Gigabyte1973/Gigabyte1973/README.md

# Gigabyte1973
BMS with RS485 comunication
