Gigabyte1973/Gigabyte1973/RS485 Slave BMS V3.3.brd

## EAGLE design RS485 Slave BMS V3.3.brd (2019-11-26)

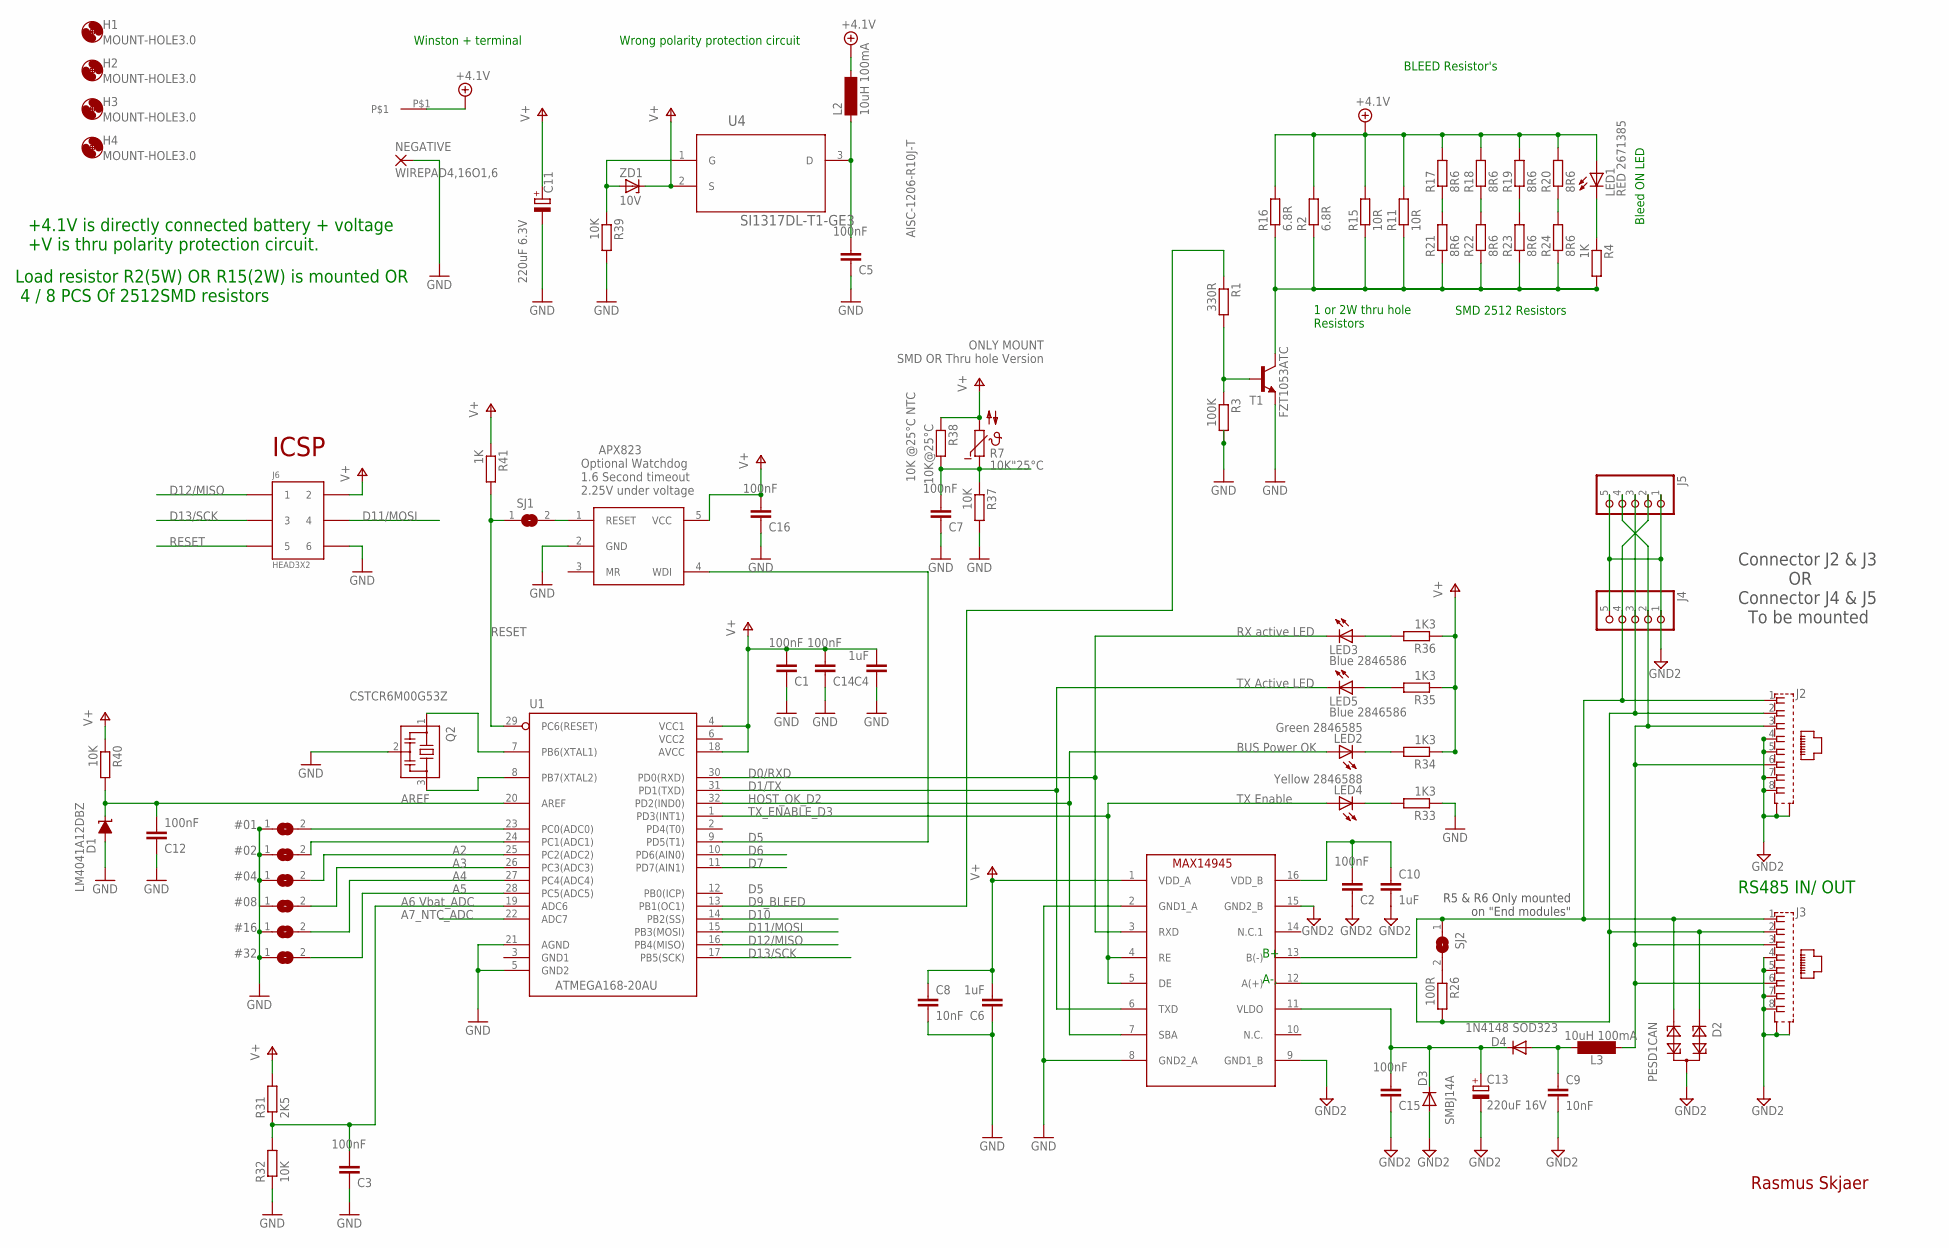
[picture p1: schematic RS485 Slave BMS V3.3.sch]

Parts:
#01, #02, #04, #08, #16, #32: SJ
C1, C2, C3, C5, C7, C12, C14, C15, C16: 100nF; C0603
C4, C6: 1uF; C0805
C8, C9: 10nF; C0603
C10: 1uF; C1206
C11: 220uF 6.3V; CT6032
C13: 220uF 16V; D/7343-31R
D1: LM4041A12DBZ; DBZ_R-PDSO-G3
D2: PESD1CAN; SOT23
D3: SMBJ14A; DO214AC
D4: 1N4148 SOD323; SOD323-R
H1, H2, H3, H4: MOUNT-HOLE3.0; 3,0
IC2: MAX14945; SOW16
J2, J3: 555153-1
J4, J5: PINHD-1X5/90; 1X05/90
J6: HEAD3X2
L2, L3: 10uH 100mA; SM-1206
LED1: RED 2671385; CHIP-LED0805
LED2: Green 2846585; CHIP-LED0805
LED3, LED5: Blue 2846586; CHIP-LED0805
LED4: Yellow 2846588; CHIP-LED0805
NEGATIVE: WIREPAD4,16O1,6; 4,16O1,6
Q2: CSTCR6M00G53Z; CSTCR6M
R1: 330R; R0603
R2, R16: 6.8R; V235/17
R3: 100K; R0603
R4, R41: 1K; R0603
R7: 10K"25°C; B57164
R11, R15: 10R; V234/12
R17, R18, R19, R20, R21, R22, R23, R24: 8R6; R2512
R26: 100R; R0805
R31: 2K5; R0603
R32, R37, R39, R40: 10K; R0603
R33, R34, R35, R36: 1K3; R0603
R38: 10K@25°C; R0603
SJ1, SJ2: SJ
T1: FZT1053ATC; SOT223
U1: ATMEGA168-20AU; QFP032
U2: APX823SOT25*; SOT23-5L
U4: SI1317DL-T1-GE3; SOT65P210X110-3N
U$1: WINSTON-160AH-TERMINAL
ZD1: 10V; SOD123

Connections:
+4.1V: L2.2, LED1.A, R2.2, R11.2, R15.2, R16.2, R17.2, R18.2, R19.2, R20.2, U$1.P$1
A2: #04.2, U1.25 (PC2(ADC2))
A3: #08.2, U1.26 (PC3(ADC3))
A4: #16.2, U1.27 (PC4(ADC4))
A5: #32.2, U1.28 (PC5(ADC5))
A6: C3.1, R31.1, R32.2, U1.19 (ADC6)
A7_NTC_ADC: C7.1, R7.1, R37.1, R38.2, U1.22 (ADC7)
A-: D2.1, IC2.12 (A(+)), J2.2, J3.2, J4.3, J5.3, R26.2
AREF: C12.1, D1.1 (C), R40.2, U1.20 (AREF)
B+: D2.2, IC2.13 (B(-)), J2.1, J3.1, J4.4, J5.2, SJ2.1
BLEED: R2.1, R4.2, R11.1, R15.1, R16.1, R21.1, R22.1, R23.1, R24.1, T1.4 (C)
D0/RXD: IC2.3 (RXD), LED3.C, U1.30 (PD0(RXD))
D1/TX: IC2.6 (TXD), LED5.C, U1.31 (PD1(TXD))
D5: U1.9 (PD5(T1)), U2.4 (WDI)
D6: U1.10 (PD6(AIN0))
D7: U1.11 (PD7(AIN1))
D9_BLEED: R1.1, U1.13 (PB1(OC1))
D10: U1.14 (PB2(SS))
D11/MOSI: J6.4, U1.15 (PB3(MOSI))
D12/MISO: J6.1, U1.16 (PB4(MISO))
D13/SCK: J6.3, U1.17 (PB5(SCK))
DCIN: J2.3, J2.6, J3.3, J3.6, J4.2, J5.4, L3.2
GND: #01.1, #02.1, #04.1, #08.1, #16.1, #32.1, C1.2, C3.2, C4.1, C5.2, C6.1, C7.2, C8.2, C11.-, C12.2, C14.2, C16.2, D1.2 (A), IC2.2 (GND1_A), IC2.8 (GND2_A), J6.6, NEGATIVE.1, Q2.2, R3.2, R32.1, R33.1, R37.2, R39.2, T1.3 (E), U1.5 (GND2), U1.21 (AGND), U2.2 (GND)
GND1: U1.3 (GND1)
GND2: C2.2, C9.2, C10.2, C13.-, C15.2, D2.3, D3.A, IC2.9 (GND1_B), IC2.15 (GND2_B), J2.4, J2.5, J2.7, J2.8, J2.G1 (S1), J2.G2 (S2), J3.4, J3.5, J3.7, J3.8, J3.G1 (S1), J3.G2 (S2), J4.1, J4.5, J5.1, J5.5
HOST_OK_D2: IC2.7 (SBA), LED2.A, U1.32 (PD2(IND0))
unnamed: R1.2, R3.1, T1.1 (B)
unnamed: #02.2, U1.24 (PC1(ADC1))
unnamed: LED4.C, R33.2
unnamed: LED3.A, R36.2
unnamed: R39.1, U4.1 (G), ZD1.A
unnamed: LED5.A, R35.2
unnamed: C5.1, L2.1, U4.3 (D)
unnamed: #01.2, U1.23 (PC0(ADC0))
unnamed: LED2.C, R34.2
unnamed: LED1.C, R4.1
unnamed: SJ1.2, U2.1 (RESET)
unnamed: C9.1, D4.A, L3.1
unnamed: R26.1, SJ2.2
unnamed: R20.1, R24.2
unnamed: R19.1, R23.2
unnamed: R18.1, R22.2
unnamed: R17.1, R21.2
unnamed: Q2.1, U1.7 (PB6(XTAL1))
unnamed: Q2.3, U1.8 (PB7(XTAL2))
RESET: J6.5, R41.2, SJ1.1, U1.29 (PC6(RESET))
TX_ENABLE_D3: IC2.4 (RE), IC2.5 (DE), LED4.A, U1.1 (PD3(INT1))
V+: C1.1, C4.2, C6.2, C8.1, C11.+, C14.1, C16.1, IC2.1 (VDD_A), J6.2, R7.2, R31.2, R34.1, R35.1, R36.1, R38.1, R40.1, R41.1, U1.4 (VCC1), U1.18 (AVCC), U2.5 (VCC), U4.2 (S), ZD1.C
VCC2: U1.6 (VCC2)
VCC2_FILTER: C13.+, C15.1, D3.C, D4.C, IC2.11 (VLDO)
VDD_B: C2.1, C10.1, IC2.16 (VDD_B)

Notes on the sheet:
BLEED Resistor's
Bleed ON LED
Wrong polarity protection circuit
+4.1V is directly connected battery + voltage +V is thru polarity protection circuit.
Load resistor R2(5W) OR R15(2W) is mounted OR 4 / 8 PCS Of 2512SMD resistors
Winston + terminal
SMD 2512 Resistors
1 or 2W thru hole Resistors
RX active LED
TX Enable
TX Active LED
10K @25°C NTC
Rasmus Skjaer
RS485 IN/ OUT
R5 & R6 Only mounted on "End modules"
Connector J2 & J3 OR Connector J4 & J5 To be mounted
AISC-1206-R10J-T
ONLY MOUNT SMD OR Thru hole Version
A-,
ICSP
APX823 Optional Watchdog 1.6 Second timeout 2.25V under voltage
BUS Power OK
A6 Vbat_ADC

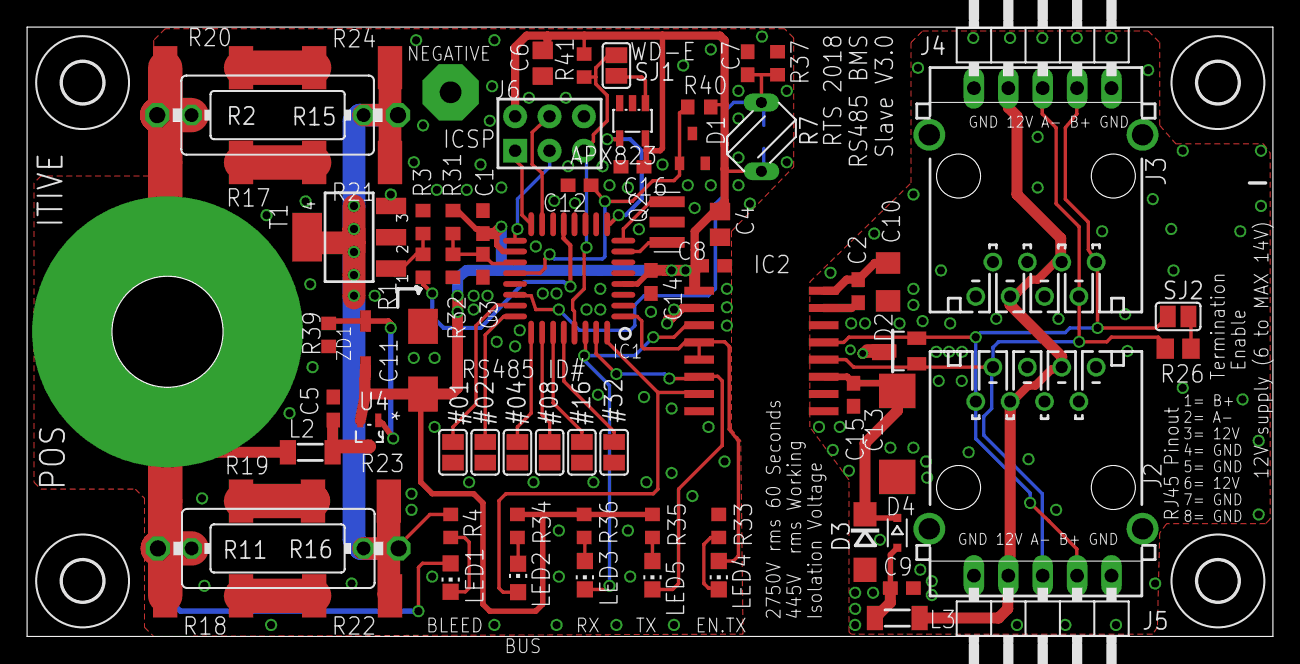
[picture p2: board RS485 Slave BMS V3.3.brd from above]

Board: 2 copper layers, 92.0 x 45.0 mm, 82 parts (1 on the bottom side), 46 nets.

Other parts of the board:
U$2: A4L-LOC
