Gigabyte1973/Gigabyte1973/Rs485 current sense V1.1.brd

## EAGLE design Rs485 current sense V1.1.brd (2019-11-26)

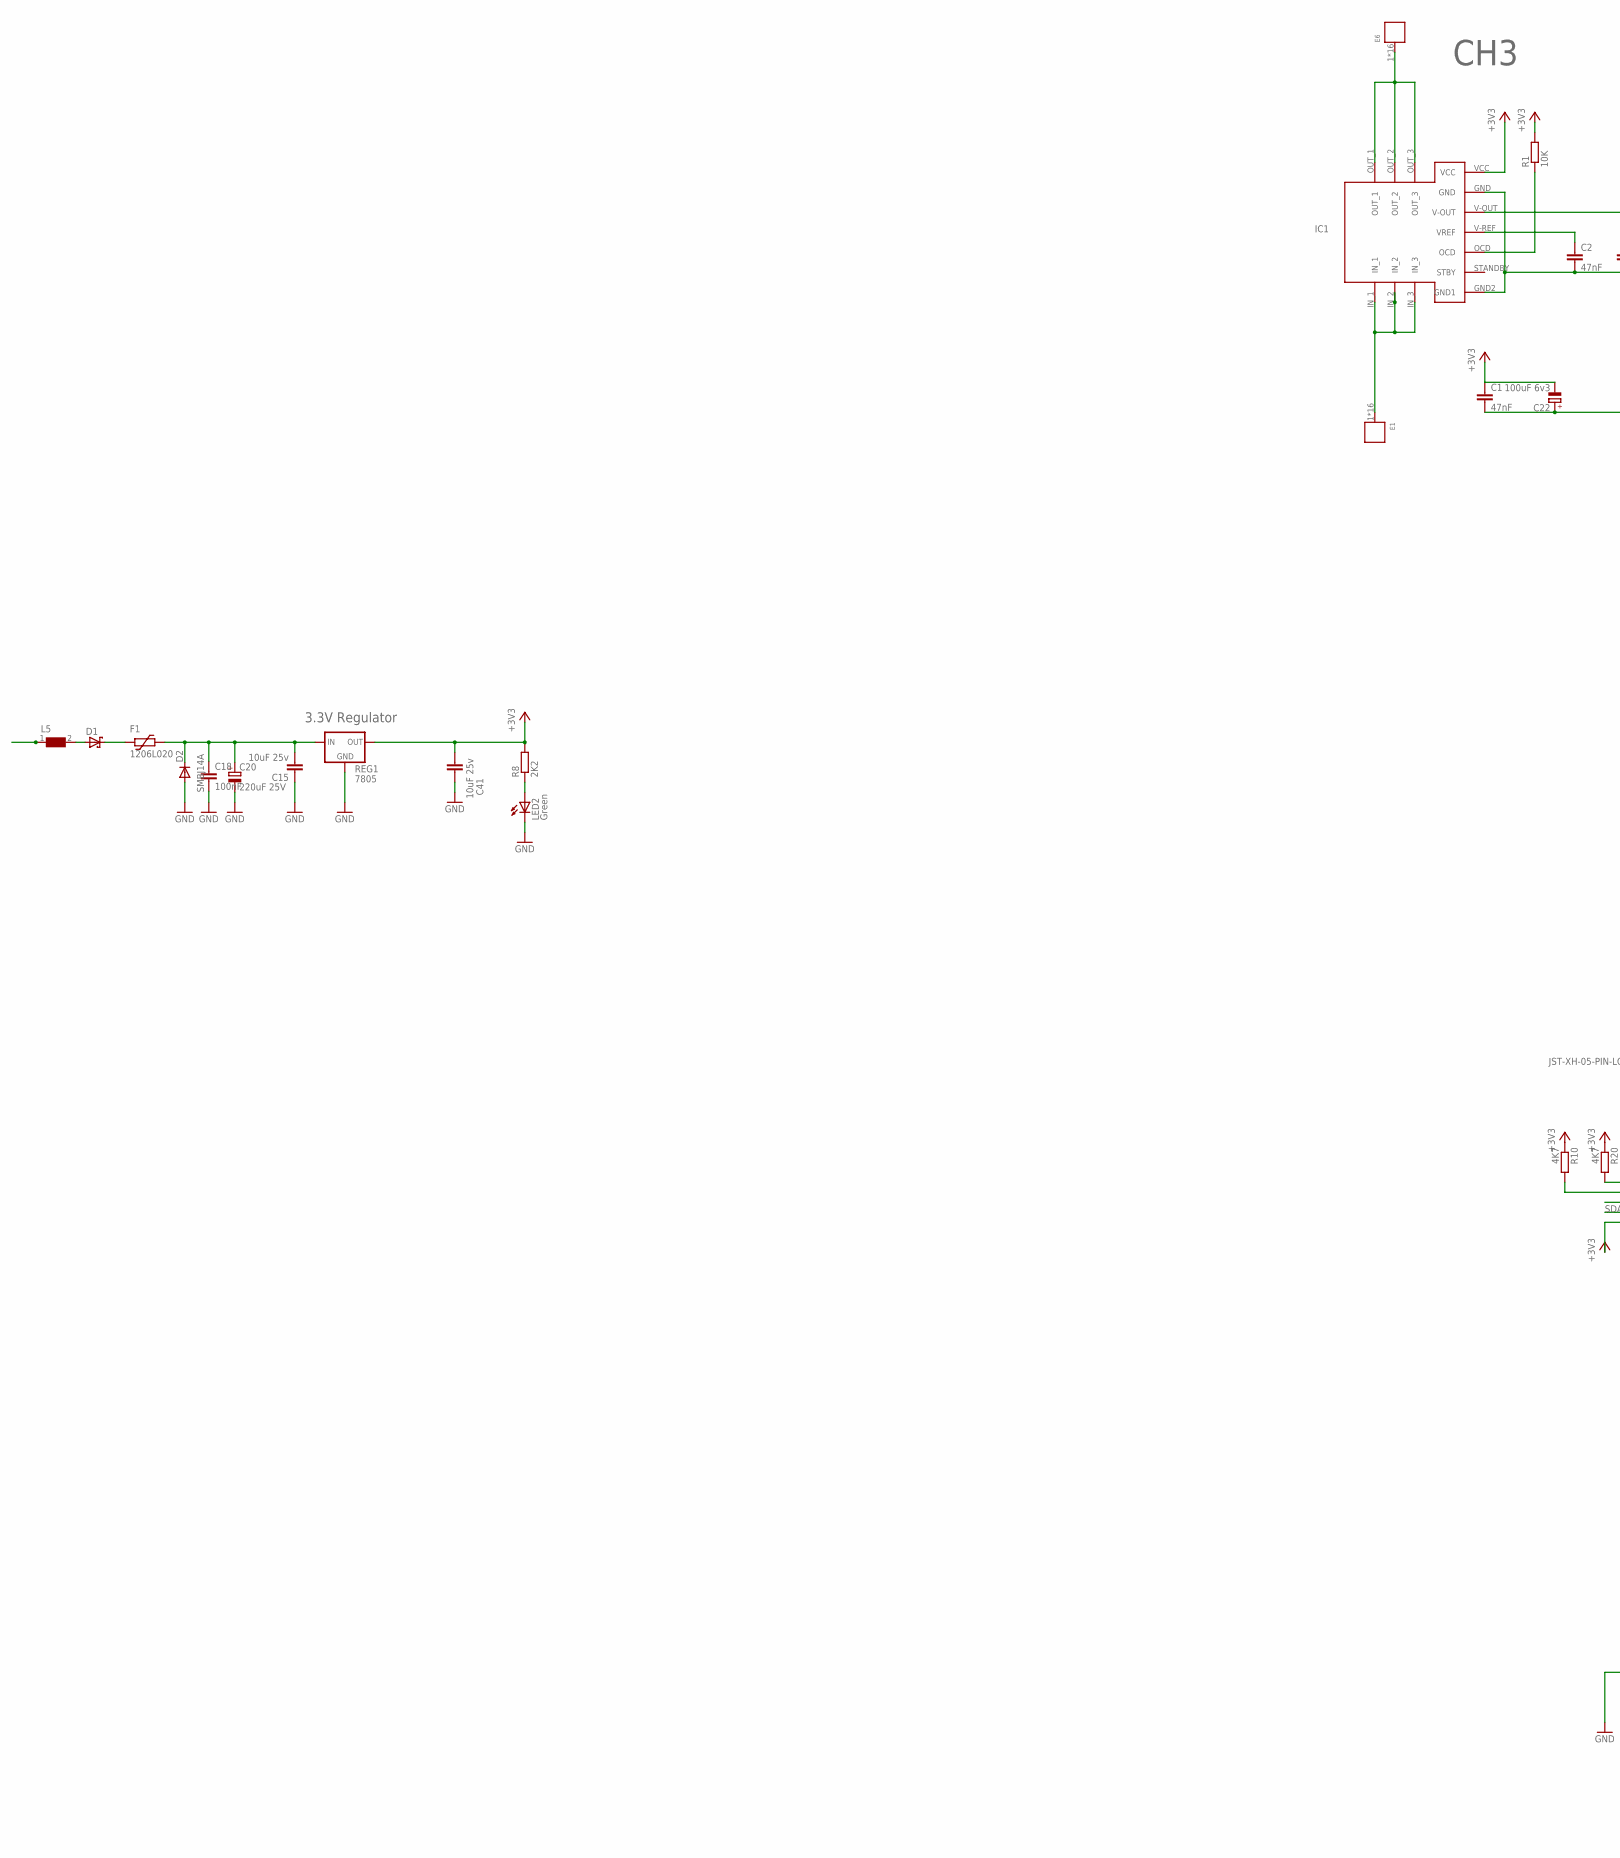
[picture p3: schematic Rs485 current sense V1.1.sch, part in row 1, column 1]

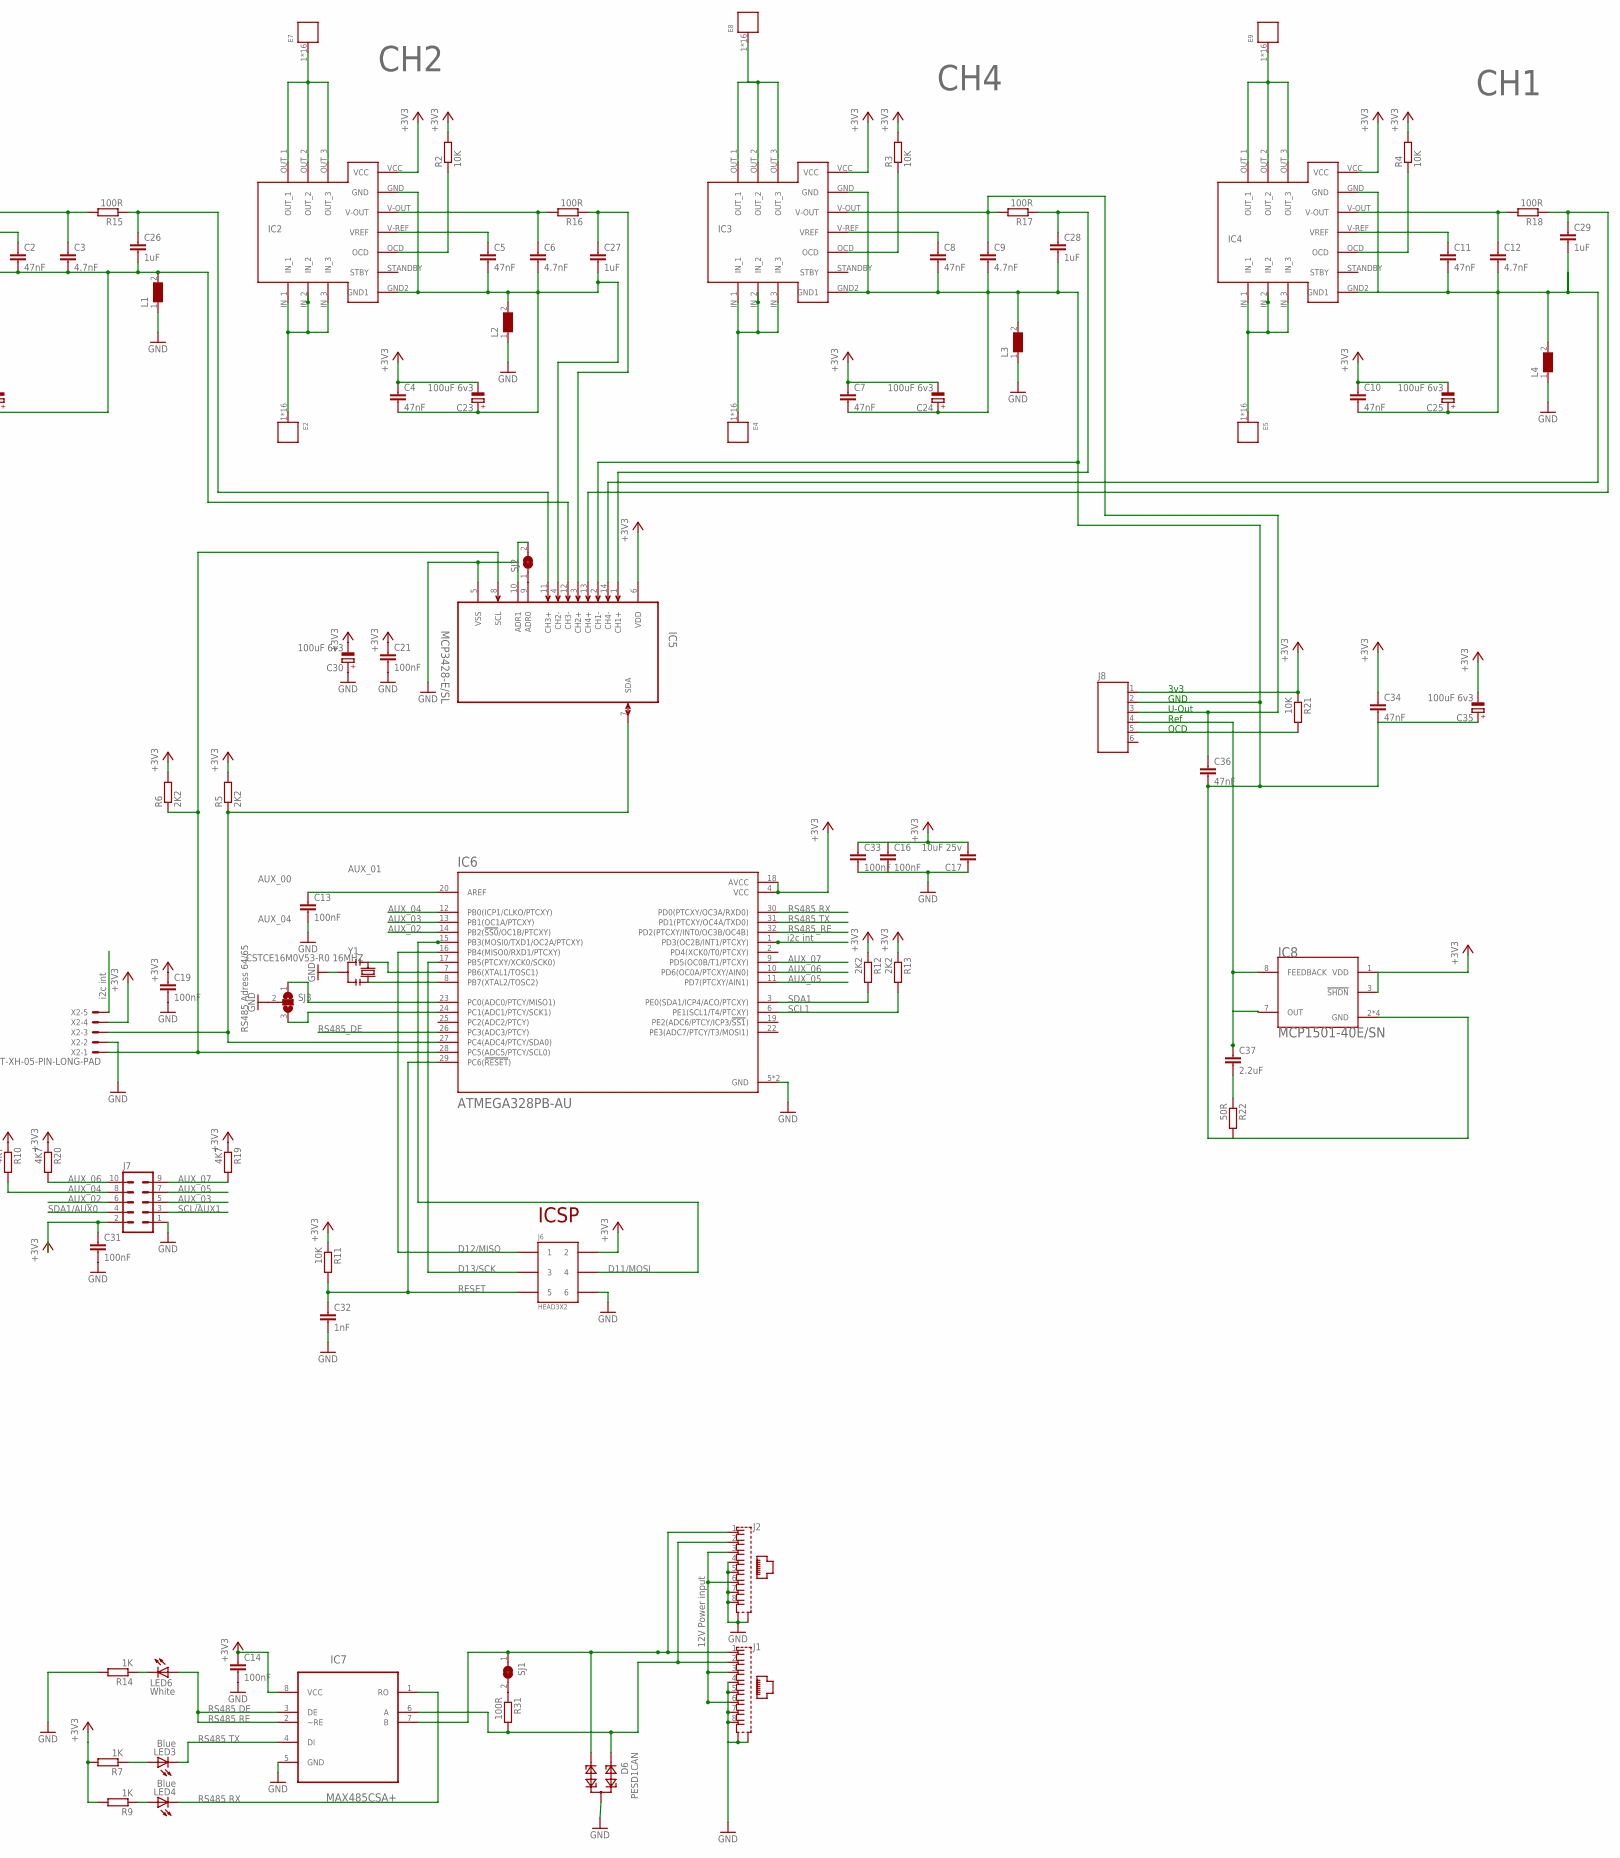
[picture p4: schematic Rs485 current sense V1.1.sch, part in row 1, column 2]

Parts:
C1, C2, C4, C5, C7, C8, C10, C11, C34, C36: 47nF; C0603
C3, C6, C9, C12: 4.7nF; C0603
C13, C14, C16, C18, C19, C21, C31, C33: 100nF; C0603
C15, C17, C41: 10uF 25v; C1206
C20: 220uF 25V; PANASONIC_F
C22, C23, C24, C25, C30, C35: 100uF 6v3; CT3528
C26, C27, C28, C29: 1uF; C0603
C32: 1nF; C0603
C37: 2.2uF; C0805
D1: SCHOTTKY-DIODESMD; SMB
D2: SMBJ14A; DO214AC
D6: PESD1CAN; SOT23
E1, E2, E4, E5, E6, E7, E8, E9: WP-BUFU_J(10); 16PINS_10X10_FULL
F1: 1206L020; 1206L
IC1, IC2, IC3, IC4: HO15-NP/SP33-1000
IC5: MCP3428-E/SL; SOIC127P600X175-14N
IC6: ATMEGA328PB-AU; QFP80P900X900X120-32N
IC7: MAX485CSA+; SOIC127P600X175-8N
IC8: MCP1501-40E/SN; SOIC127P600X175-8N
J1, J2: 555153-1
J6: HEAD3X2
J7: MA05-2
J8: JST-PH6
L1, L2, L3, L4: WE-CBF-74279209_0805; 0805
L5: WE-CBF-7427922_1206; 1206
LED2: Green; CHIPLED_0805
LED3, LED4: Blue; CHIPLED_0805
LED6: White; CHIPLED_0805
R1, R2, R3, R4, R11, R21: 10K; R0603
R5, R6, R12, R13: 2K2; R0603
R7, R9, R14: 1K; R0805
R8: 2K2; R0805
R10, R19, R20: 4K7; R0603
R15, R16, R17, R18: 100R; R0603
R22: 50R; R0603
R31: 100R; R0805
REG1: 7805; 78XXS
SJ1, SJ2: SJ
SJ3: SJ2W; SJ_2
X2: JST-XH-05-PIN-LONG-PAD; JST-XH-05-PACKAGE-LONG-PAD
Y1: CSTCE16M0V53-R0 16MHZ; RESONATOR

Connections:
1GNDA: C10.2, C11.2, C12.2, C25.- (+), C29.2, IC4.GND, IC4.GND2 (GND1), IC5.14 (CH4-), L4.2
1_IN: E5.1, E5.2, E5.3, E5.4, E5.5, E5.6, E5.7, E5.8, E5.9, E5.10, E5.11, E5.12, E5.13, E5.14, E5.15, E5.16, IC4.IN_1, IC4.IN_2, IC4.IN_3
1_OUT: E9.1, E9.2, E9.3, E9.4, E9.5, E9.6, E9.7, E9.8, E9.9, E9.10, E9.11, E9.12, E9.13, E9.14, E9.15, E9.16, IC4.OUT_1, IC4.OUT_2, IC4.OUT_3
2GND: C4.2, C5.2, C6.2, C23.- (+), C27.2, IC2.GND, IC2.GND2 (GND1), IC5.4 (CH2-), L2.2
2_IN: E2.1, E2.2, E2.3, E2.4, E2.5, E2.6, E2.7, E2.8, E2.9, E2.10, E2.11, E2.12, E2.13, E2.14, E2.15, E2.16, IC2.IN_1, IC2.IN_2, IC2.IN_3
2_OUT: E7.1, E7.2, E7.3, E7.4, E7.5, E7.6, E7.7, E7.8, E7.9, E7.10, E7.11, E7.12, E7.13, E7.14, E7.15, E7.16, IC2.OUT_1, IC2.OUT_2, IC2.OUT_3
3GND: C1.2, C2.2, C3.2, C22.- (+), C26.2, IC1.GND, IC1.GND2 (GND1), IC5.12 (CH3-), L1.2
3_IN: E1.1, E1.2, E1.3, E1.4, E1.5, E1.6, E1.7, E1.8, E1.9, E1.10, E1.11, E1.12, E1.13, E1.14, E1.15, E1.16, IC1.IN_1, IC1.IN_2, IC1.IN_3
3_OUT: E6.1, E6.2, E6.3, E6.4, E6.5, E6.6, E6.7, E6.8, E6.9, E6.10, E6.11, E6.12, E6.13, E6.14, E6.15, E6.16, IC1.OUT_1, IC1.OUT_2, IC1.OUT_3
4GNDA: C7.2, C8.2, C9.2, C24.- (+), C28.2, C34.2, C35.- (+), C36.2, IC3.GND, IC3.GND2 (GND1), IC5.2 (CH1-), IC8.2 (GND), IC8.4 (GND), IC8.5 (GND), IC8.6 (GND), J8.2, L3.2, R22.2
4_IN: E4.1, E4.2, E4.3, E4.4, E4.5, E4.6, E4.7, E4.8, E4.9, E4.10, E4.11, E4.12, E4.13, E4.14, E4.15, E4.16, IC3.IN_1, IC3.IN_2, IC3.IN_3
4_OUT: E8.1, E8.2, E8.3, E8.4, E8.5, E8.6, E8.7, E8.8, E8.9, E8.10, E8.11, E8.12, E8.13, E8.14, E8.15, E8.16, IC3.OUT_1, IC3.OUT_2, IC3.OUT_3
12V: J1.3, J1.6, J2.3, J2.6, L5.1
+3V3: C1.1, C4.1, C7.1, C10.1, C14.1, C16.1, C17.2, C19.1, C21.1, C22.+ (-), C23.+ (-), C24.+ (-), C25.+ (-), C30.+ (-), C31.1, C33.1, C34.1, C35.+ (-), C41.2, IC1.VCC, IC2.VCC, IC3.VCC, IC4.VCC, IC5.6 (VDD), IC6.4 (VCC), IC6.18 (AVCC), IC7.8 (VCC), IC8.1 (VDD), IC8.3 (!SHDN), J6.2, J7.2, J8.1, R1.2, R2.2, R3.2, R4.2, R5.2, R6.2, R7.2, R8.2, R9.2, R10.1, R11.1, R12.1, R13.1, R19.1, R20.1, R21.1, REG1.OUT, X2.4
ATMEGA-AREF: C13.1, IC6.20 (AREF)
AUX_02: IC6.14 (PB2(!SS0!/OC1B/PTCXY)), J7.6
AUX_03: IC6.13 (PB1(OC1A/PTCXY)), J7.5
AUX_04: IC6.12 (PB0(ICP1/CLKO/PTCXY)), J7.8, R10.2
AUX_05: IC6.11 (PD7(PTCXY/AIN1)), J7.7
AUX_06: IC6.10 (PD6(OC0A/PTCXY/AIN0)), J7.10, R20.2
AUX_07: IC6.9 (PD5(OC0B/T1/PTCXY)), J7.9, R19.2
CH1-OUTA: C29.1, IC5.13 (CH4+), R18.1
CH2-OUT: C27.1, IC5.3 (CH2+), R16.1
CH3-OUT: C26.1, IC5.11 (CH3+), R15.1
CH4-OUTA: C28.1, IC5.1 (CH1+), R17.1
D11/MOSI: IC6.15 (PB3(MOSI0/TXD1/OC2A/PTCXY)), J6.4
D12/MISO: IC6.16 (PB4(MISO0/RXD1/PTCXY)), J6.1
D13/SCK: IC6.17 (PB5(PTCXY/XCK0/SCK0)), J6.3
GND: C13.2, C14.2, C15.1, C16.2, C17.1, C18.2, C19.2, C20.-, C21.2, C30.- (+), C31.2, C32.2, C33.2, C41.1, D2.A, D6.3, IC5.5 (VSS), IC5.10 (ADR1), IC6.5 (GND), IC6.21 (GND), IC7.5 (GND), J1.4, J1.5, J1.7, J1.8, J1.G1 (S1), J1.G2 (S2), J2.4, J2.5, J2.7, J2.8, J2.G1 (S1), J2.G2 (S2), J6.6, J7.1, L1.1, L2.1, L3.1, L4.1, LED2.C, R14.2, REG1.GND, SJ2.2, SJ3.2, X2.2, Y1.2
I2C_INT: IC6.1 (PD3(OC2B/INT1/PTCXY)), X2.5
I2C_SCL: IC5.8 (SCL), IC6.28 (PC5(ADC5/PTCY/SCL0)), R6.1, X2.1
I2C_SDA: IC5.7 (SDA), IC6.27 (PC4(ADC4/PTCY/SDA0)), R5.1, X2.3
unnamed: IC6.23 (PC0(ADC0/PTCY/MISO1)), SJ3.1
unnamed: IC1.OCD, R1.1
unnamed: IC6.24 (PC1(ADC1/PTCY/SCK1)), SJ3.3
unnamed: C2.1, IC1.V-REF (VREF)
unnamed: J8.5, R21.2
unnamed: C9.1, C36.1, IC3.V-OUT, J8.3, R17.2
unnamed: C37.1, IC8.7 (OUT), IC8.8 (FEEDBACK), J8.4
unnamed: IC2.OCD, R2.1
unnamed: C5.1, IC2.V-REF (VREF)
unnamed: C6.1, IC2.V-OUT, R16.2
unnamed: C37.2, R22.1
unnamed: D1.A, L5.2
unnamed: IC3.OCD, R3.1
unnamed: C8.1, IC3.V-REF (VREF)
unnamed: IC4.OCD, R4.1
unnamed: C11.1, IC4.V-REF (VREF)
unnamed: IC6.8 (PB7(XTAL2/TOSC2)), Y1.3
unnamed: LED2.A, R8.1
unnamed: D1.C, F1.2
unnamed: LED3.A, R7.1
unnamed: LED4.A, R9.1
unnamed: LED6.C, R14.1
unnamed: IC5.9 (ADR0), SJ2.1
unnamed: C3.1, IC1.V-OUT, R15.2
unnamed: C12.1, IC4.V-OUT, R18.2
unnamed: R31.1, SJ1.2
RESET: C32.1, IC6.29 (PC6(!RESET!)), J6.5, R11.2
RS485_DE: IC6.26 (PC3(ADC3/PTCY)), IC7.2 (~RE), IC7.3 (DE), LED6.A
RS485_N: D6.1, IC7.6 (A), J1.2, J2.2, R31.2
RS485_P: D6.2, IC7.7 (B), J1.1, J2.1, SJ1.1
RS485_RE: IC6.32 (PD2(PTCXY/INT0/OC3B/OC4B))
RS485_RX: IC6.30 (PD0(PTCXY/OC3A/RXD0)), IC7.1 (RO), LED4.C
RS485_TX: IC6.31 (PD1(PTCXY/OC4A/TXD0)), IC7.4 (DI), LED3.C
SCL1: IC6.6 (PE1(SCL1/T4/PTCXY)), J7.3, R13.2
SDA1: IC6.3 (PE0(SDA1/ICP4/ACO/PTCXY)), J7.4, R12.2
VBAT12V: C15.2, C18.1, C20.+, D2.C, F1.1, REG1.IN
XTAL2: IC6.7 (PB6(XTAL1/TOSC1)), Y1.1

Notes on the sheet:
RS485 TX
RS485 RX
RS485 RE
RS485 DE
3.3V Regulator
IC1
IC2
IC3
IC4
ICSP
RS485_RE
RS485_DE
AUX_06
AUX_07
AUX_05
AUX_03
AUX_04
AUX_02
AUX_01
AUX_00
SCL1
SDA1
SDA1/AUX0
SCL/AUX1
RS485 Adress 64/65
3v3
GND
Ref
U-Out
OCD
CH4
CH1
CH2
CH3
i2c int
12V Power input

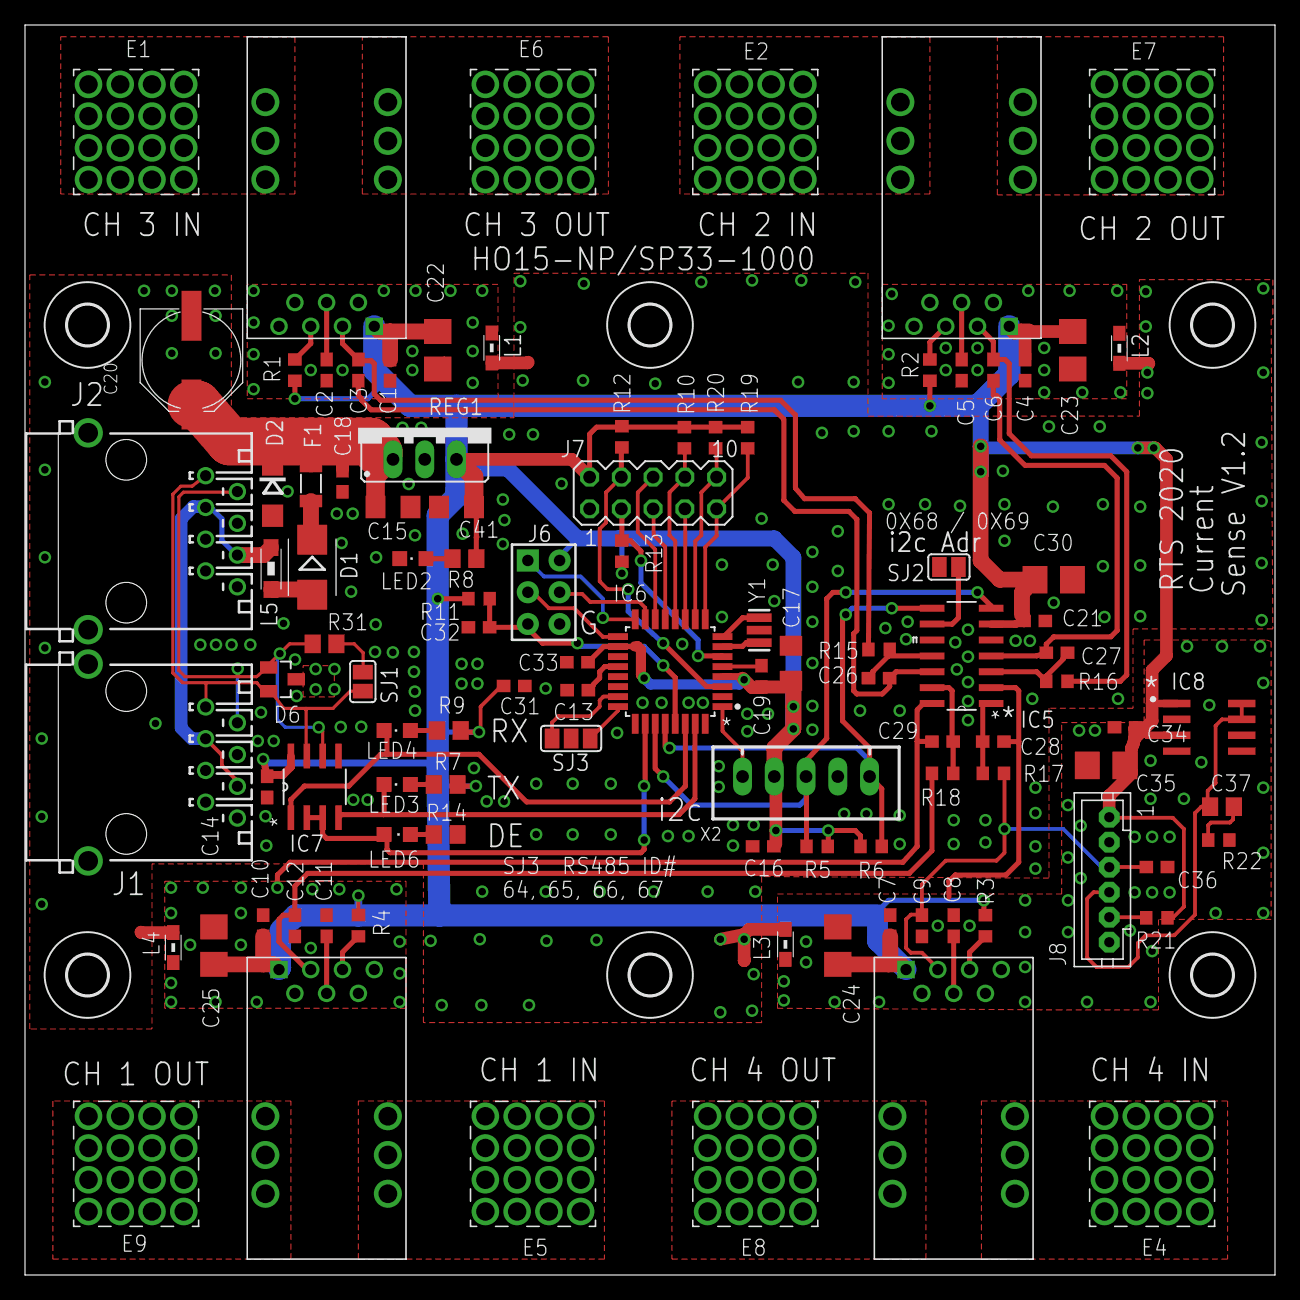
[picture p5: board Rs485 current sense V1.1.brd from above]

Board: 2 copper layers, 100.0 x 100.0 mm, 107 parts (0 on the bottom side), 68 nets.

Other parts of the board:
U$2, U$3, U$4, U$5, U$6, U$7: 3,2
