Gigabyte1973/Gigabyte1973/BMS Master Teensy V 2.22 move 4G.brd

## EAGLE design BMS Master Teensy V 2.22 move 4G.brd (2019-11-26)

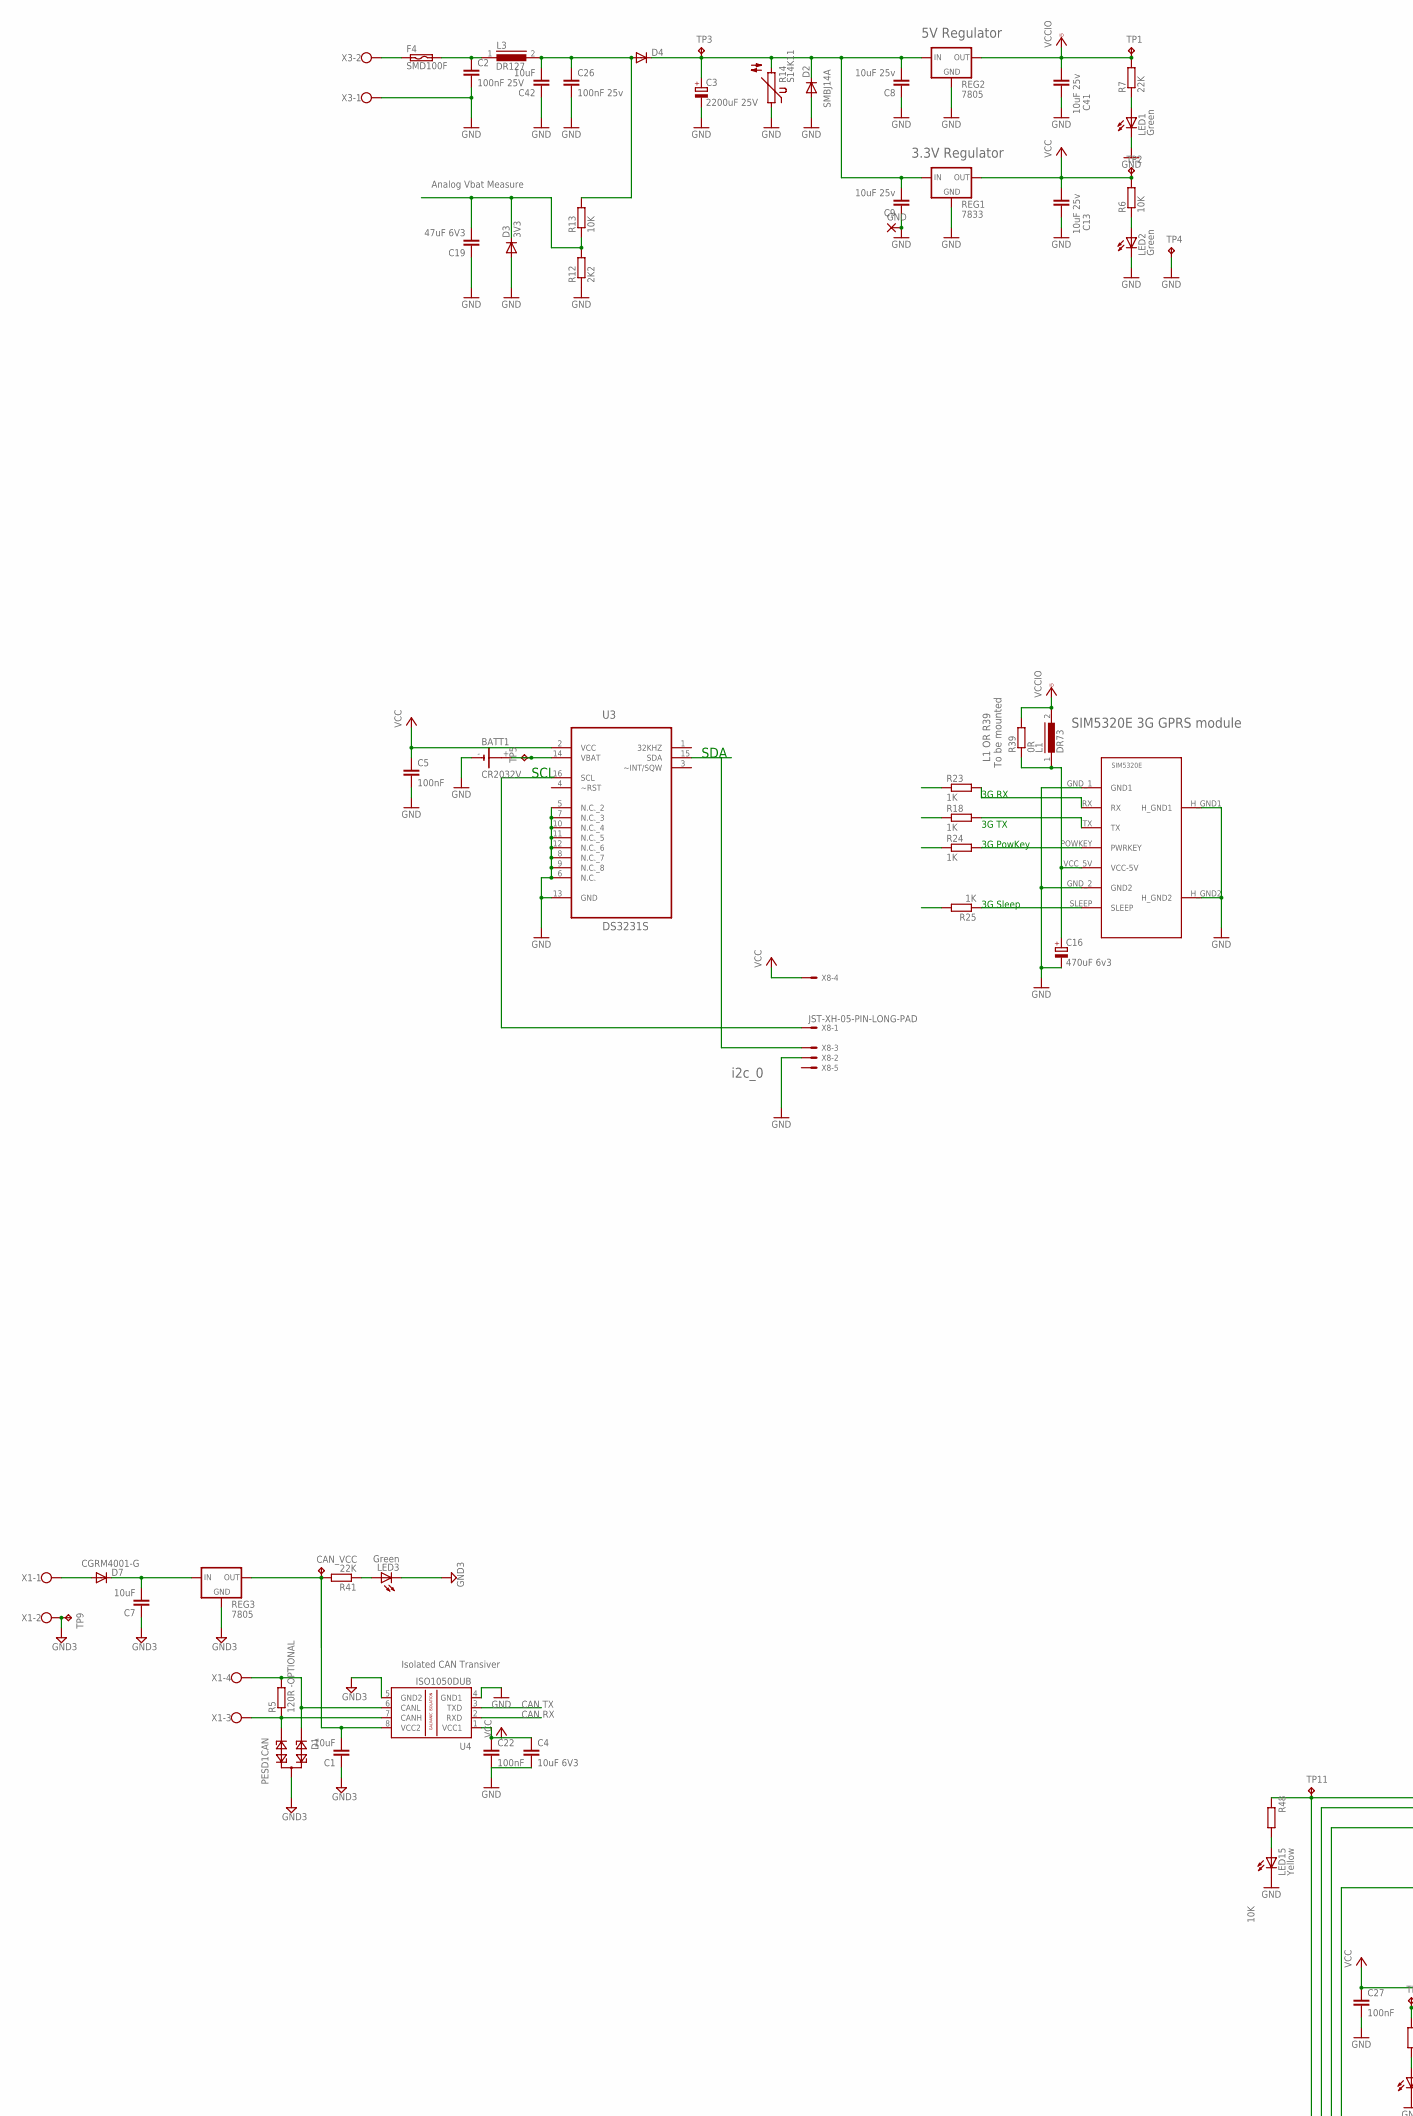
[picture p6: schematic BMS Master Teensy V 2.22 move 4G.sch, part in row 1, column 1]

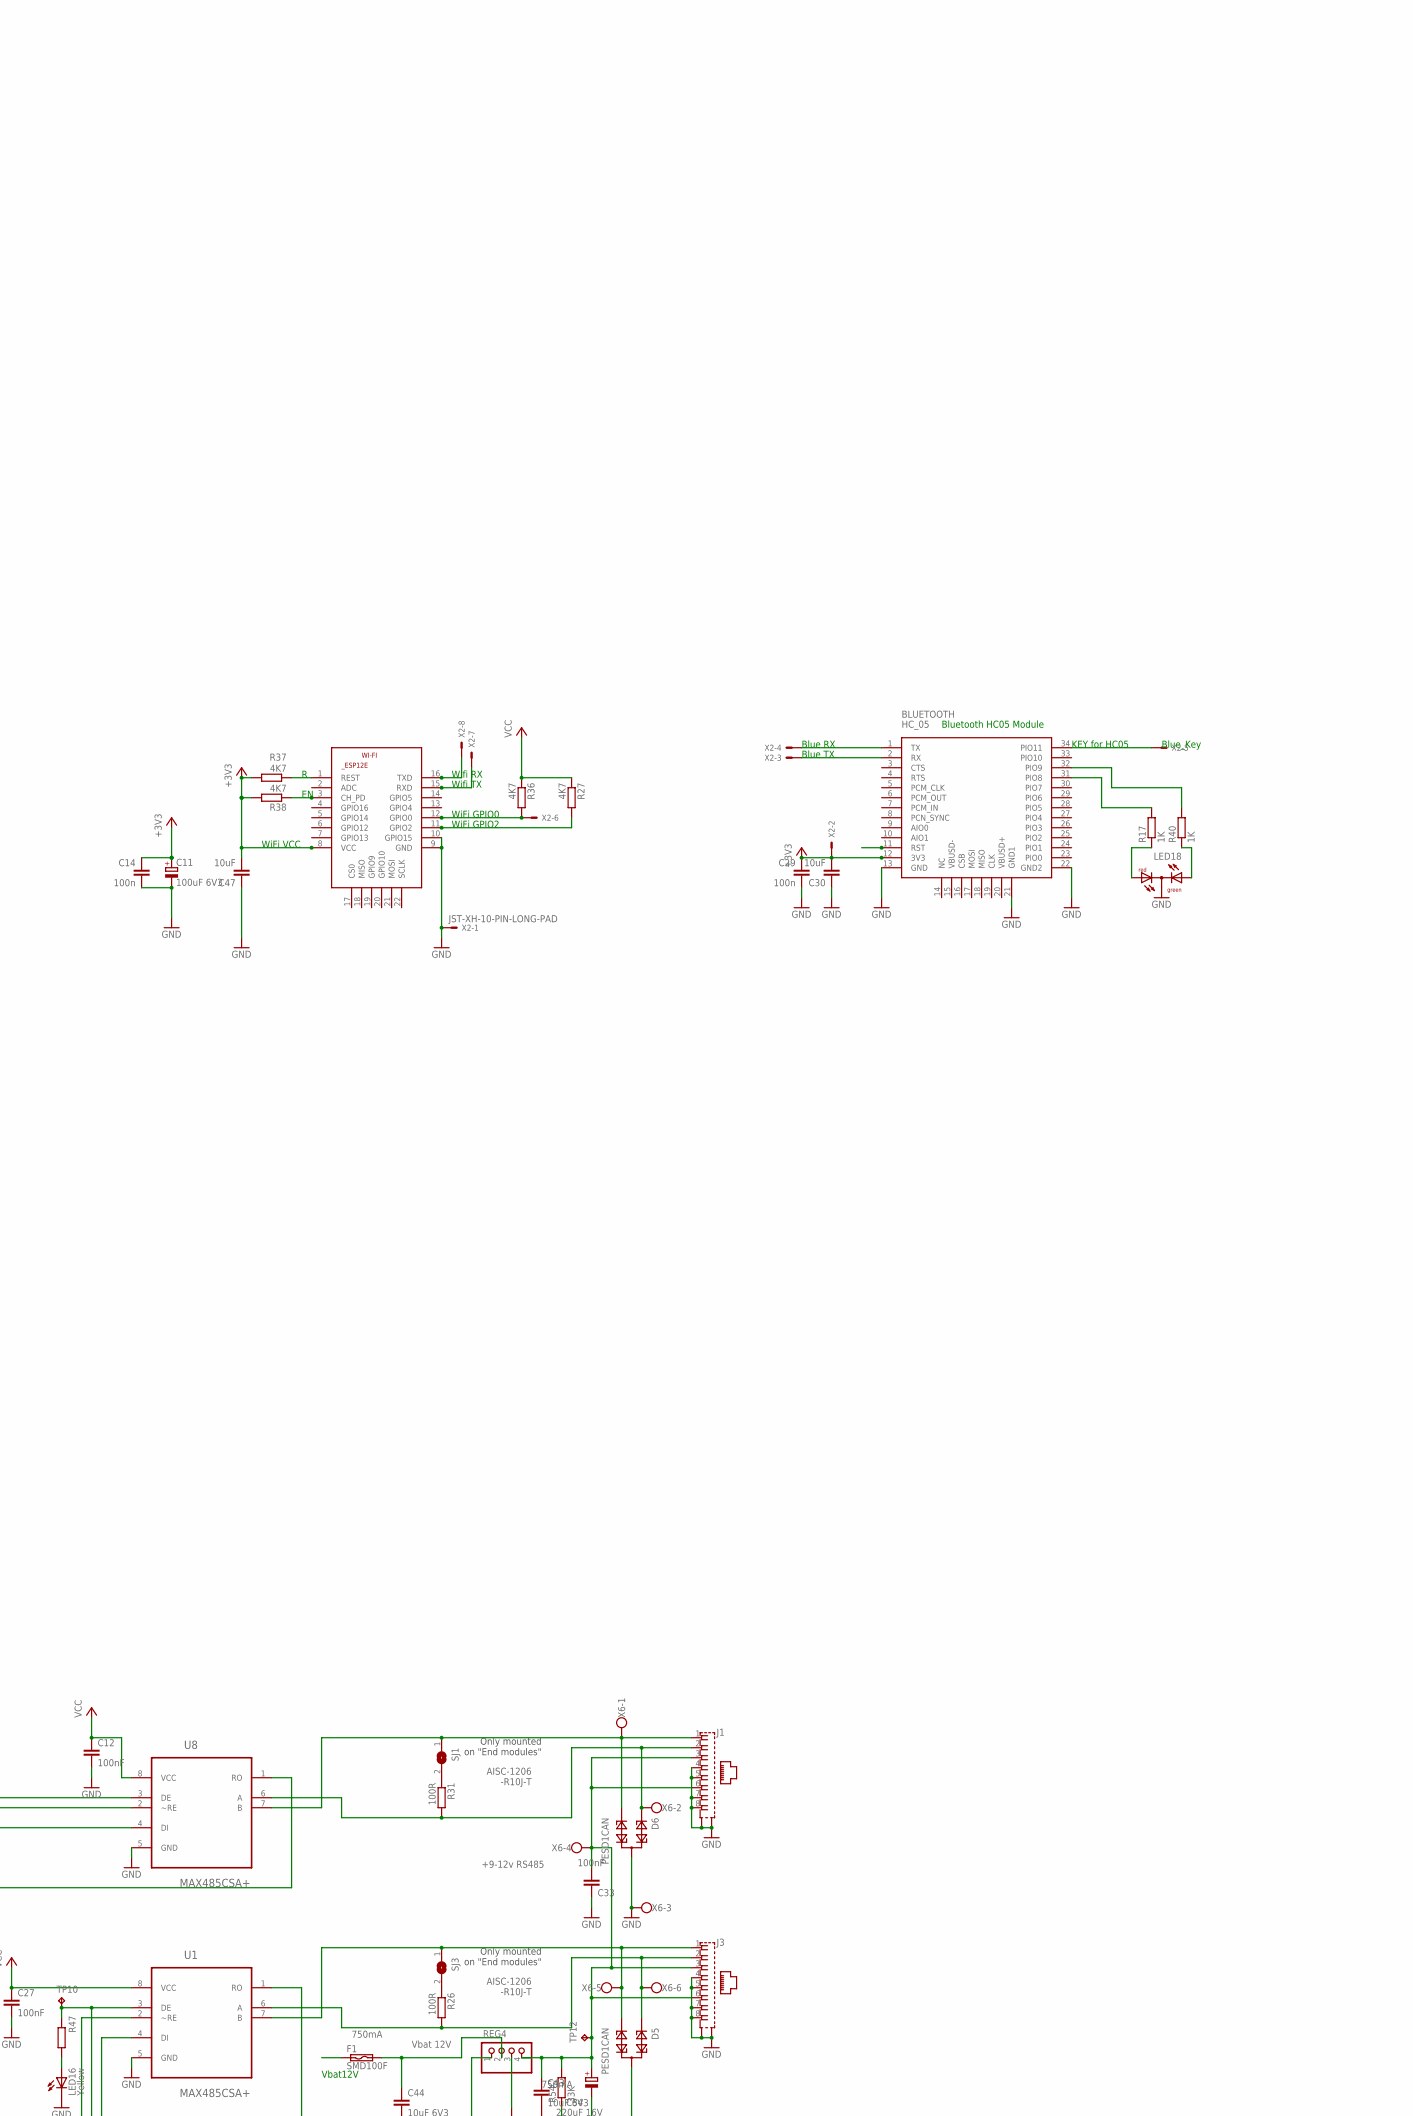
[picture p7: schematic BMS Master Teensy V 2.22 move 4G.sch, part in row 1, column 2]

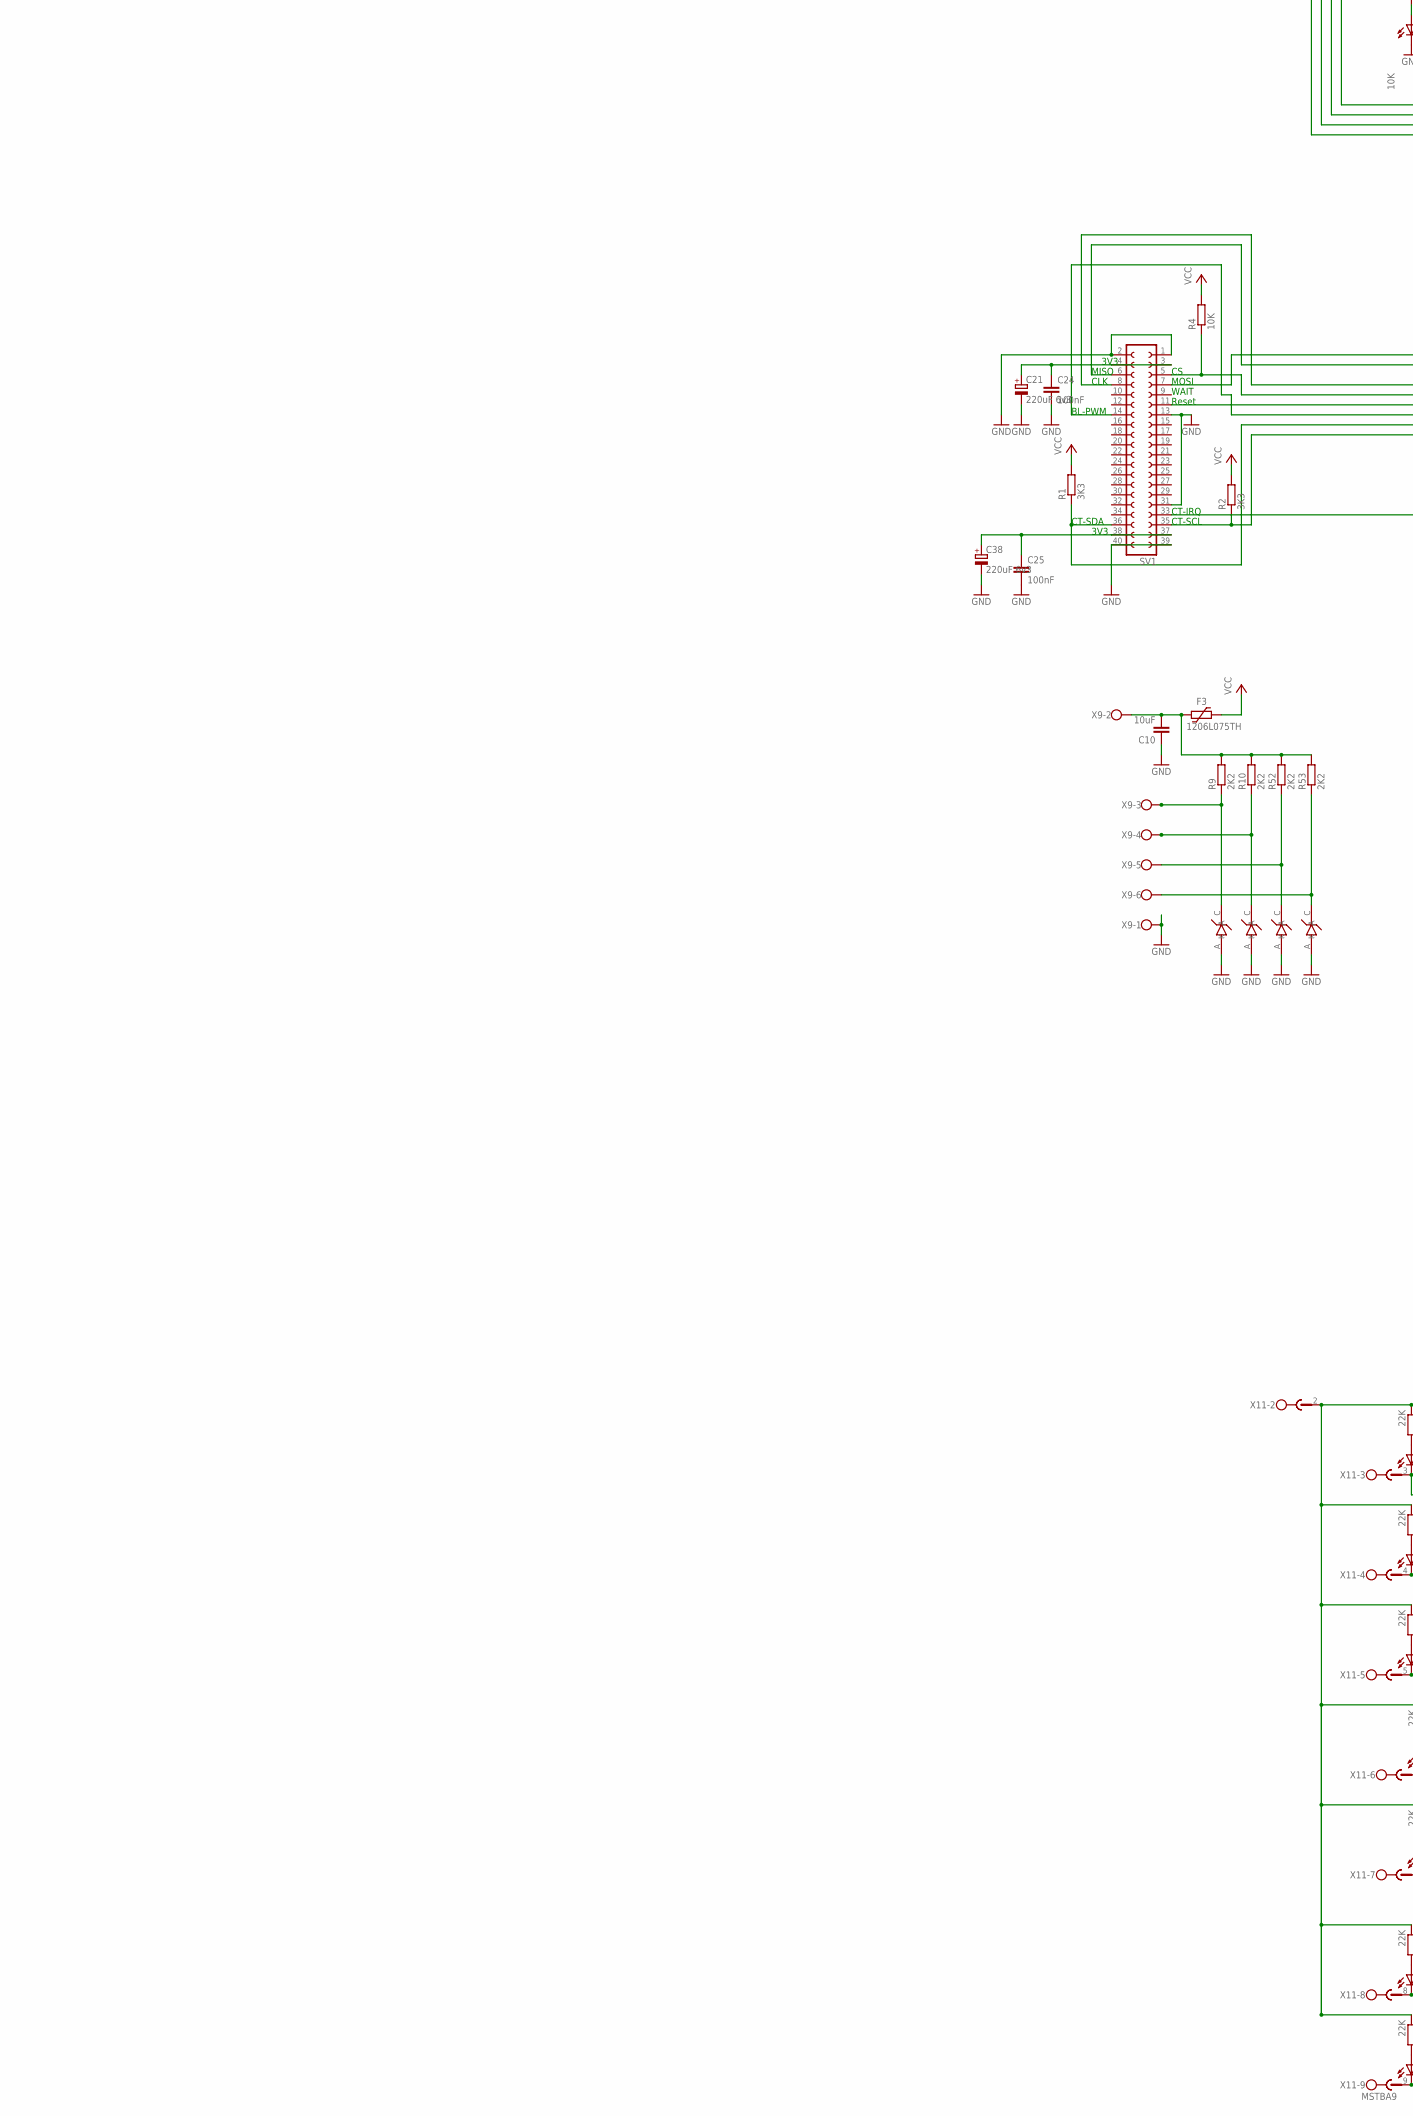
[picture p8: schematic BMS Master Teensy V 2.22 move 4G.sch, part in row 2, column 1]

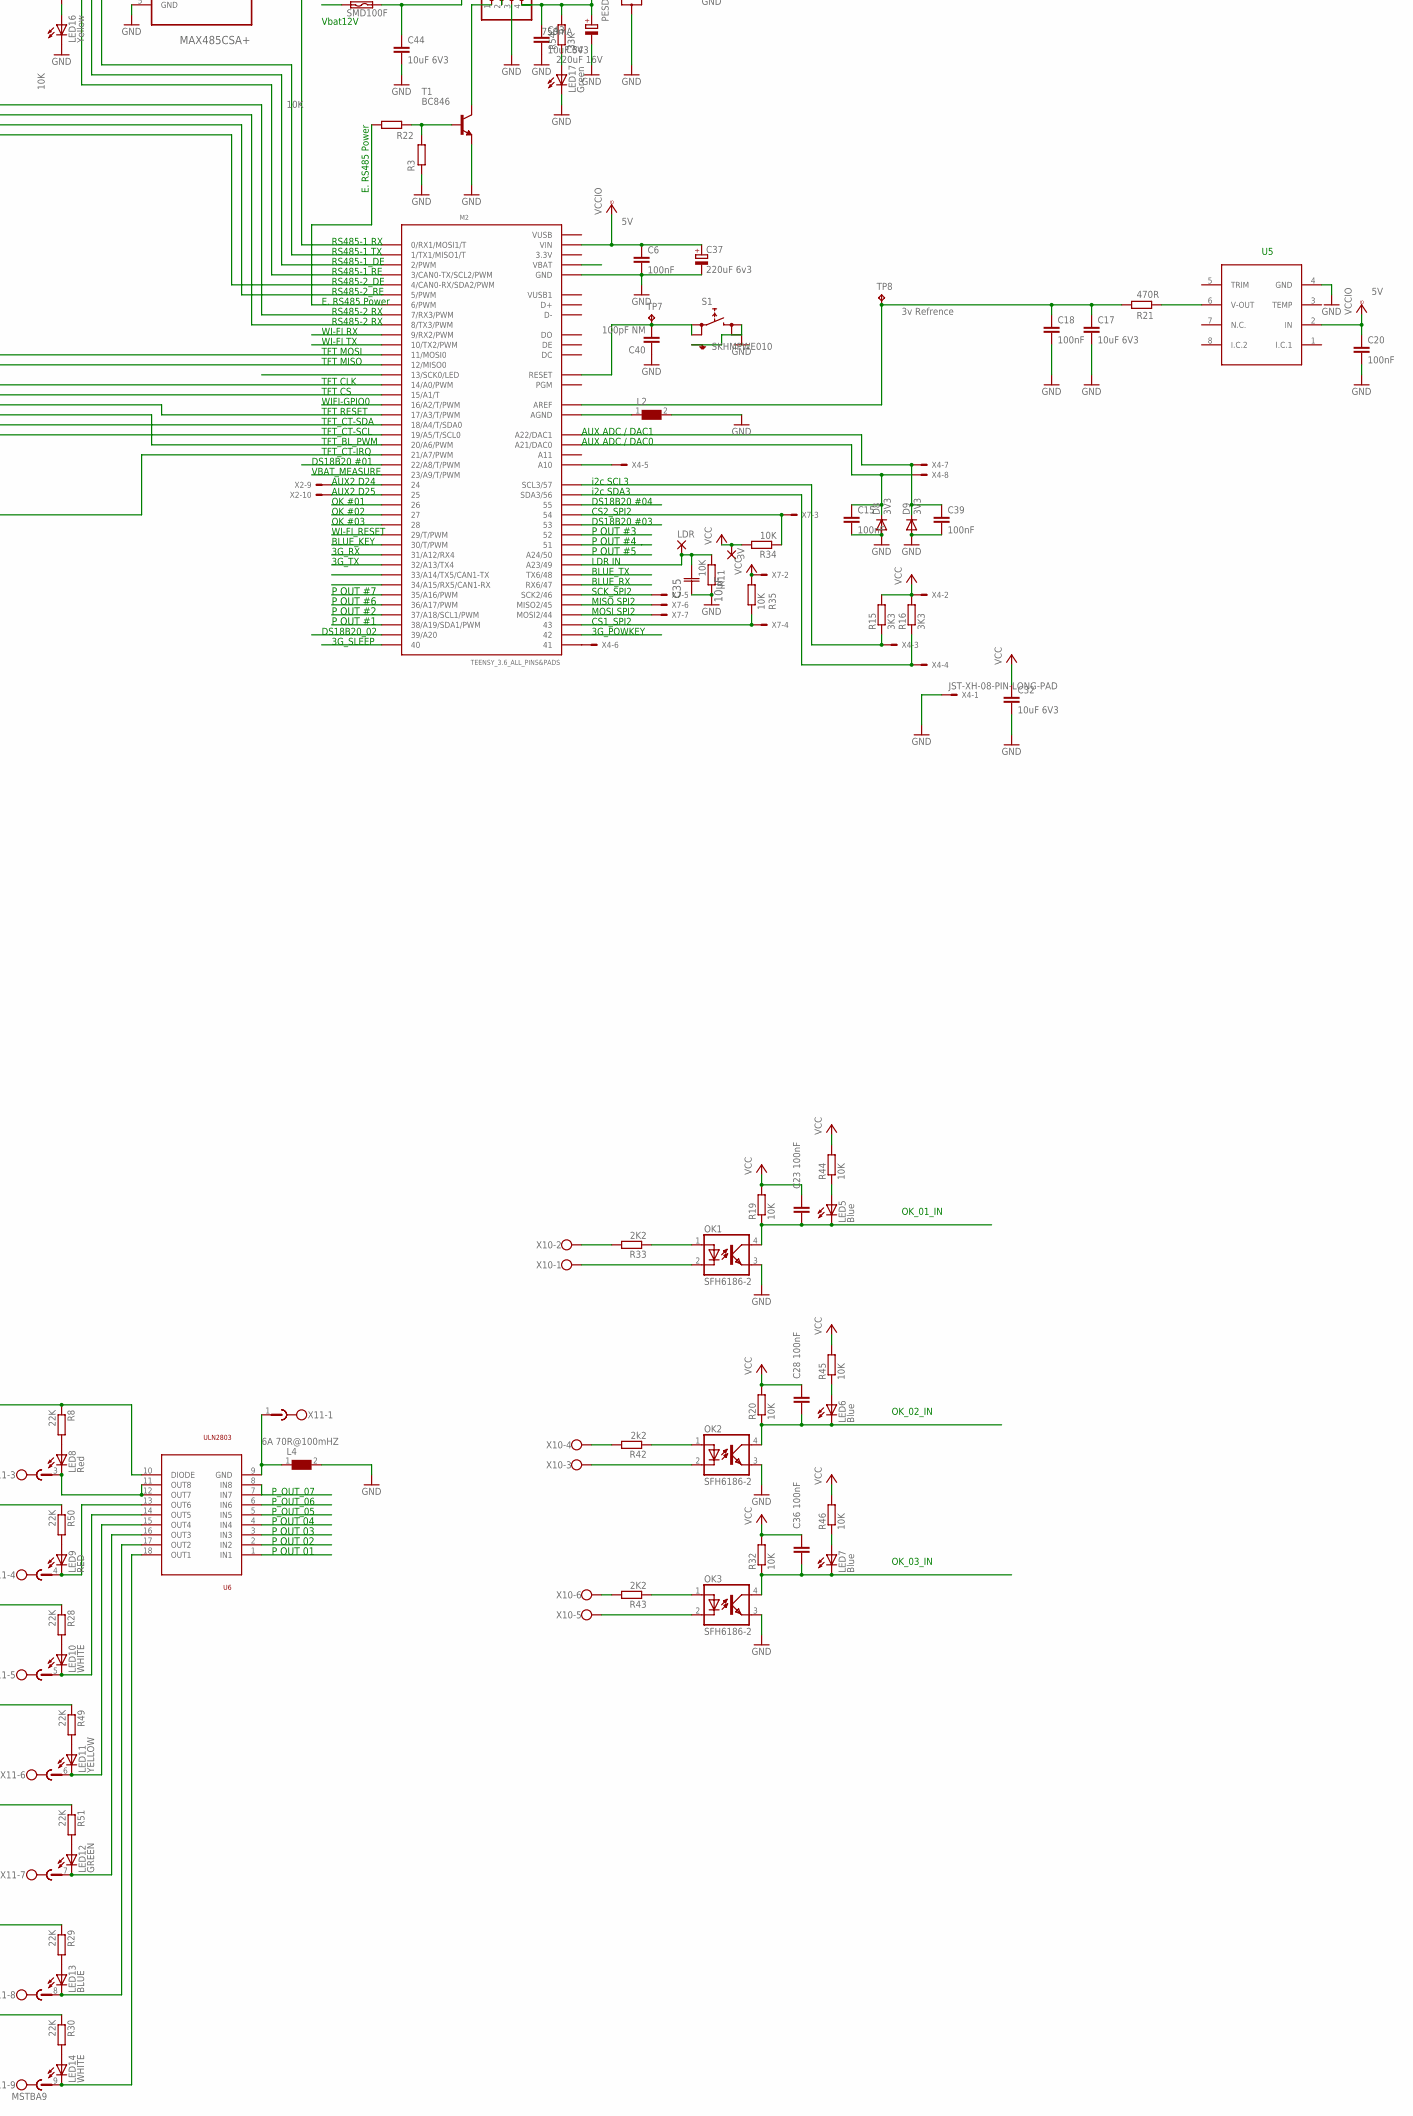
[picture p9: schematic BMS Master Teensy V 2.22 move 4G.sch, part in row 2, column 2]

Parts:
3V: 1,6/0,8
BATT1: CR2032V
BLUETOOTH: HC_05; BLUETOOTH_SMD
C1, C7, C10, C30, C42, C47: 10uF; C1206
C2: 100nF 25V; C0805
C3: 2200uF 25V; E5-10,5
C4, C17, C32, C43, C44: 10uF 6V3; C1206
C5, C6, C12, C15, C18, C20, C22, C24, C25, C27, C33, C39: 100nF; C0603
C8, C9, C13, C41: 10uF 25v; C1206
C11: 100uF 6V3; CT6032
C14, C29: 100n; C0603-ROUND
C16: 470uF 6v3; CT7343
C19: 47uF 6V3; C1206
C21, C37, C38: 220uF 6v3; CT7343
C23, C28, C36: 100nF; C0805
C26: 100nF 25v; C0603
C34: 220uF 16V; CT7343
C35: 10µF; CAPC2012X140N
C40: 100pF NM; C0603
CAN_VCC: TPB2,54; B2,54
D1, D5, D6: PESD1CAN; SOT23
D2: SMBJ14A; DO214AC
D3, D8, D9: 3V3; SOD80C
D4: DIODE-SMC; SMC
D7: CGRM4001-G; SOD-123_MINI-SMA
D10, D11, D12, D13: SOD-323_ZENER_DIODE; SOD323_ST
F1, F4: SMD100F; SMD050F
F3: 1206L075TH; 1206L
GND: 1,6/0,9
J1, J3: 555153-1
L1: DR73
L2: WE-CBF-74279201_0805; 0805
L3: DR127
L4: WE-CBF-742792510_1812; 1812
LDR: 1,6/0,8
LED1, LED2, LED3, LED17: Green; CHIPLED_0805
LED5, LED6, LED7: Blue; CHIPLED_0805
LED8: Red; CHIP-LED0805
LED9: RED; CHIP-LED0805
LED10, LED14: WHITE; CHIP-LED0805
LED11: YELLOW; CHIP-LED0805
LED12: GREEN; CHIP-LED0805
LED13: BLUE; CHIP-LED0805
LED15, LED16: Yellow; CHIPLED_0805
LED18: DUOLED-RG-C; DUOLED-C-5MM
M1: SIM5320_MODULE; SIM5320E_MODULE
M2: TEENSY_3.6_ALL_PINS&PADS
OK1, OK2, OK3: SFH6186-2; SMD4-7
R1, R2, R15, R16: 3K3; R0603
R3: 1M; R0603
R4, R11, R13, R22, R34, R35, R47, R48: 10K; R0603
R5: 120R -OPTIONAL; R0603
R6, R19, R20, R32, R44, R45, R46: 10K; R0805
R7, R41: 22K; R0805
R8, R28, R29, R30, R49, R50, R51: 22K; R0603
R9, R10, R12, R52, R53: 2K2; R0603
R14: S14K11
R17, R18, R23, R24, R25, R40: 1K; R0603
R21: 470R; R0603
R26, R31: 100R; R0805
R27, R36, R37, R38: 4K7; R0603
R33, R43: 2K2; R0805
R39: 0R; R0603
R42: 2k2; R0805
R54: 33K; R0805
REG1: 7833; 78XXS
REG2, REG3: 7805; 78XXS
REG4: PINHD-1X4; 1X04
S1: SKHMPWE010; SKHMPXE010
SJ1, SJ3: SJ
SV1: FE20-2
T1: BC846; SOT23
TP1, TP2, TP3, TP4, TP5, TP7, TP8, TP9, TP12: TPB2,54; B2,54
TP10, TP11: TPB1,27; B1,27
U1, U8: MAX485CSA+; SOIC127P600X175-8N
U3: DS3231S; SOIC127P1032X265-16N
U4: ISO1050DUB; DUB-R-PDSO-G8
U5: U5; MAX6177AASA+
U6: ULN2803; SO18L
WI-FI: ESP8266-12EESP12E; ESP8266-ESP12E
X1: W237-4
X2: JST-XH-10-PIN-LONG-PAD; JST-XH-10-PACKAGE-LONG-PAD
X3: W237-102
X4: JST-XH-08-PIN-LONG-PAD; JST-XH-08-PACKAGE-LONG-PAD
X6, X9, X10: W237-6
X7: JST-XH-07-PIN-LONG-PAD; JST-XH-07-PACKAGE-LONG-PAD
X8: JST-XH-05-PIN-LONG-PAD; JST-XH-05-PACKAGE-LONG-PAD
X11: MSTBA9

Connections:
3.3V: M2.3.3V, M2.3.3V2 (3.3V), M2.3.3V3 (3.3V), M2.3.3V4 (3.3V)
3G_POWKEY: M2.42, R24.1
3G_RX: M2.31/A12 (31/A12/RX4), R18.1
3G_SLEEP: M2.40, R25.2
3G_TX: M2.32/A13 (32/A13/TX4), R23.1
18B20_VCC: C10.2, F3.2, R9.2, R10.2, R52.2, R53.2, X9.2
A10: M2.A10, X4.5
A-: D5.1, J3.2, R26.2, U1.6 (A), X6.6
A-1: D6.1, J1.2, R31.2, U8.6 (A), X6.2
AUX_ADC-DAC_1: C39.1, D9.C, M2.A22 (A22/DAC1), X4.7
B+: D5.2, J3.1, SJ3.1, U1.7 (B), X6.5
B+1: D6.2, J1.1, SJ1.1, U8.7 (B), X6.1
BL-PWM: M2.20/A6 (20/A6/PWM), SV1.14
BLUE_KEY: BLUETOOTH.34 (PIO11), M2.30 (30/T/PWM), X2.5
BLUE_RX: BLUETOOTH.1 (TX), M2.47 (RX6/47), X2.4
BLUE_TX: BLUETOOTH.2 (RX), M2.48 (TX6/48), X2.3
CAN-L: D1.1, R5.2, U4.6 (CANL), X1.4
CAN_RX: M2.34/A15 (34/A15/RX5/CAN1-RX), U4.2 (RXD)
CAN_TX: M2.33/A14 (33/A14/TX5/CAN1-TX), U4.3 (TXD)
CAN_VBAT_12V: D7.A, X1.1
CHARGE_A(1): C15.1, D8.C, M2.A21 (A21/DAC0), X4.8
CS1_SPI2: M2.43, R35.1, X7.4
CS2_SPI2: M2.54, R34.1, X7.3
CT-IRQ: M2.21/A7 (21/A7/PWM), SV1.33
D24: M2.24, X2.9
D25: M2.25, X2.10
D41: M2.41, X4.6
DCIN: C33.1, C34.+, C43.1, J1.3, J1.6, J3.3, J3.6, R54.2, REG4.4, TP12.TP, X6.4
DS18B20_01: D13.C (K), M2.22/A8 (22/A8/T/PWM), R9.1, X9.3
DS18B20_02: D12.C (K), M2.39/A20, R10.1, X9.4
DS18B20_03: D11.C (K), M2.53, R52.1, X9.5
DS18B20_04: D10.C (K), M2.55, R53.1, X9.6
E_RS485_POWER: M2.6 (6/PWM), R22.1
GND: BATT1.-, BLUETOOTH.13 (GND), BLUETOOTH.21 (GND1), BLUETOOTH.22 (GND2), C2.2, C3.-, C4.2, C5.2, C6.2, C8.1, C9.1, C10.1, C11.-, C12.2, C13.1, C14.2, C15.2, C16.-, C17.2, C18.2, C19.1, C20.2, C21.-, C22.2, C24.2, C25.2, C26.2, C27.2, C29.2, C30.1, C32.2, C33.2, C34.-, C35.1 (C1), C37.-, C38.-, C39.2, C40.1, C41.1, C42.1, C43.2, C44.2, C47.1, D2.A, D3.A, D5.3, D6.3, D8.A, D9.A, D10.A, D11.A, D12.A, D13.A, GND.1, J1.4, J1.5, J1.7, J1.8, J1.G1 (S1), J1.G2 (S2), J3.4, J3.5, J3.7, J3.8, J3.G1 (S1), J3.G2 (S2), L2.2, L4.2, LED1.C, LED2.C, LED15.C, LED16.C, LED17.C, LED18.C, M1.GND_1 (GND1), M1.GND_2 (GND2), M1.H_GND1, M1.H_GND2, M2.GND, M2.GND1 (GND), M2.GND2 (GND), M2.GND3 (GND), M2.GND4 (GND), M2.GND5 (GND), M2.GND6 (GND), OK1.3 (EMIT), OK2.3 (EMIT), OK3.3 (EMIT), R3.2, R11.2, R12.1, R14.1, REG1.GND, REG2.GND, REG4.3, S1.3 (2.1), S1.4 (2.2), S1.5 (SH), SV1.1, SV1.2, SV1.13, SV1.31, SV1.39, SV1.40, T1.2 (E), TP4.TP, U1.5 (GND), U3.5 (N.C._2), U3.6 (N.C.), U3.7 (N.C._3), U3.8 (N.C._7), U3.9 (N.C._8), U3.10 (N.C._4), U3.11 (N.C._5), U3.12 (N.C._6), U3.13 (GND), U4.4 (GND1), U5.4 (GND), U8.5 (GND), WI-FI.9 (GND), WI-FI.10 (GPIO15), X2.1, X3.1, X4.1, X6.3, X8.2, X9.1
GND3-CAN: C1.1, C7.1, D1.3, LED3.C, REG3.GND, TP9.TP, U4.5 (GND2), X1.2
GND-FILTERED: L4.1, U6.9 (GND), X11.1
LDR_A23: C35.2 (C2), LDR.1, M2.49 (A23/49), R11.1
MISO_SPI2: M2.45 (MISO2/45), X7.6
MOSI_SPI2: M2.44 (MOSI2/44), X7.7
unnamed: M2.0 (0/RX1/MOSI1/T), U1.1 (RO)
unnamed: M2.1 (1/TX1/MISO1/T), U1.4 (DI)
unnamed: L2.1, M2.AGND
unnamed: LED17.A, R54.1
unnamed: C2.1, F4.2, L3.1
unnamed: LED16.A, R47.1
unnamed: R3.1, R22.2, T1.1 (B)
unnamed: LED15.A, R48.1
unnamed: F4.1, X3.2
unnamed: LED11.A, R49.2
unnamed: BATT1.+, TP5.TP, U3.14 (VBAT)
unnamed: M1.TX, R18.2
unnamed: LED18.AR, R17.1
unnamed: LED3.A, R41.1
unnamed: LED9.A, R50.2
unnamed: M1.RX, R23.2
unnamed: D1.2, R5.1, U4.7 (CANH), X1.3
unnamed: LED18.AX (AG), R40.1
unnamed: LED12.A, R51.2
unnamed: LED2.A, R6.1
unnamed: LED1.A, R7.1
unnamed: C44.1, F1.2, REG4.2
unnamed: LED8.A, R8.2
unnamed: OK1.1 (A), R33.1
unnamed: R33.2, X10.2
unnamed: OK3.1 (A), R43.1
unnamed: R43.2, X10.6
unnamed: R42.2, X10.4
unnamed: BLUETOOTH.32 (PIO9), R40.2
unnamed: BLUETOOTH.31 (PIO8), R17.2
unnamed: R26.1, SJ3.2
unnamed: R21.2, U5.6 (V-OUT)
unnamed: M1.POWKEY (PWRKEY), R24.2
unnamed: M1.SLEEP, R25.1
unnamed: OK2.2 (C), X10.3
unnamed: OK3.2 (C), X10.5
unnamed: C7.2, D7.C, REG3.IN
unnamed: LED10.A, R28.2
unnamed: LED13.A, R29.2
unnamed: LED14.A, R30.2
unnamed: OK1.2 (C), X10.1
unnamed: OK2.1 (A), R42.1
unnamed: LED5.A, R44.1
unnamed: LED6.A, R45.1
unnamed: R31.1, SJ1.2
unnamed: LED7.A, R46.1
OK_01_IN: C23.2, LED5.C, M2.26, OK1.4 (COL), R19.1
OK_02_IN: C28.2, LED6.C, M2.27, OK2.4 (COL), R20.1
OK_03_IN: C36.2, LED7.C, M2.28, OK3.4 (COL), R32.1
OUT_01: LED14.C, U6.18 (OUT1), X11.9
OUT_02: LED13.C, U6.17 (OUT2), X11.8
OUT_03: LED12.C, U6.16 (OUT3), X11.7
OUT_04: LED11.C, U6.15 (OUT4), X11.6
OUT_05: LED10.C, U6.14 (OUT5), X11.5
OUT_06: LED9.C, U6.13 (OUT6), X11.4
OUT_07: LED8.C, U6.11 (OUT8), U6.12 (OUT7), X11.3
OUT_VCC_VOLTAGE: R8.1, R28.1, R29.1, R30.1, R49.1, R50.1, R51.1, U6.10 (DIODE), X11.2
P_OUT_01: M2.38/A19 (38/A19/SDA1/PWM), U6.1 (IN1)
P_OUT_02: M2.37/A18 (37/A18/SCL1/PWM), U6.2 (IN2)
P_OUT_03: M2.52, U6.3 (IN3)
P_OUT_04: M2.51, U6.4 (IN4)
P_OUT_05: M2.50 (A24/50), U6.5 (IN5)
P_OUT_06: M2.36/A17 (36/A17/PWM), U6.6 (IN6)
P_OUT_07: M2.35/A16 (35/A16/PWM), U6.7 (IN7), U6.8 (IN8)
RESET: C40.2, M2.RESET, S1.1 (1.1), S1.2 (1.2), TP7.TP
RS485-1_DE: M2.2 (2/PWM), R47.2, TP10.TP, U1.3 (DE)
RS485-1_RE: M2.3 (3/CAN0-TX/SCL2/PWM), U1.2 (~RE)
RS485-2_DE: M2.4 (4/CAN0-RX/SDA2/PWM), R48.2, TP11.TP, U8.3 (DE)
RS485-2_RE: M2.5 (5/PWM), U8.2 (~RE)
RS485-2_RX: M2.7 (7/RX3/PWM), U8.1 (RO)
RS485-2_TX: M2.8 (8/TX3/PWM), U8.4 (DI)
RS485_POWER: REG4.1, T1.3 (C)
SCK_SPI2: M2.46 (SCK2/46), X7.5
SCL: M2.19/A5 (19/A5/T/SCL0), R2.1, SV1.35, U3.16 (SCL), X8.1
SCL3: M2.57 (SCL3/57), R15.1, X4.3
SDA: M2.18/A4 (18/A4/T/SDA0), R1.1, SV1.36, U3.15 (SDA), X8.3
SDA3: M2.56 (SDA3/56), R16.1, X4.4
SIM5320E_VCC: C16.+, L1.1, M1.VCC_5V (VCC-5V), R39.1
TFT-SCK: M2.14/A0 (14/A0/PWM), SV1.8
TFT_CS: M2.15/A1 (15/A1/T), R4.1, SV1.5
TFT_MISO: M2.12 (12/MISO0), SV1.6
TFT_MOSI: M2.11 (11/MOSI0), SV1.7
TFT_RESET: M2.17/A3 (17/A3/T/PWM), SV1.11
VBAT12V: C3.+, C8.2, C9.2, D2.C, D4.C, F1.1, R14.2, REG1.IN, REG2.IN, TP3.TP
VBAT_12V: C26.1, C42.2, D4.A, L3.2, R13.2
VBAT_MEASURE: C19.2, D3.C, M2.23/A9 (23/A9/T/PWM), R12.2, R13.1
VCC3V1: C1.2, CAN_VCC.TP, R41.2, REG3.OUT, U4.8 (VCC2)
VCC3V3: 3V.1, BLUETOOTH.12 (3V3), C4.1, C5.1, C11.+, C12.1, C13.2, C14.1, C21.+, C22.1, C23.1, C24.1, C25.1, C27.1, C28.1, C29.1, C30.2, C32.1, C36.1, C38.+, C47.2, F3.1, R1.2, R2.2, R4.2, R6.2, R15.2, R16.2, R19.2, R20.2, R27.1, R32.2, R34.2, R35.2, R36.1, R37.2, R38.2, R44.2, R45.2, R46.2, REG1.OUT, SV1.3, SV1.4, SV1.37, SV1.38, TP2.TP, U1.8 (VCC), U3.2 (VCC), U4.1 (VCC1), U8.8 (VCC), WI-FI.8 (VCC), X2.2, X4.2, X7.2, X8.4
VCC5V: C6.1, C20.1, C37.+, C41.2, L1.2, M2.VIN, R7.2, R39.2, REG2.OUT, TP1.TP, U5.2 (IN)
VREF_3V: C17.1, C18.1, M2.AREF, R21.1, TP8.TP
VUSB: M2.VUSB
VUSB1: M2.VUSB1
WI-FI_RESET: M2.29 (29/T/PWM), R37.1, WI-FI.1 (REST)
WI-FI_RX: M2.9 (9/RX2/PWM), WI-FI.16 (TXD), X2.8
WI-FI_TX: M2.10 (10/TX2/PWM), WI-FI.15 (RXD), X2.7
WIFI-CH_PD: R38.1, WI-FI.3 (CH_PD)
WIFI-GPIO0: M2.16/A2 (16/A2/T/PWM), R36.2, WI-FI.12 (GPIO0), X2.6
WIFI-GPIO2: R27.2, WI-FI.11 (GPIO2)

Notes on the sheet:
3.3V Regulator
5V Regulator
Isolated CAN Transiver
CT-IRQ
CT-SCL
CT-SDA
MISO
MOSI
CLK
WAIT
Reset
BL-PWM
3V3
SCL
SDA
3v Refrence
KEY for HC05
Bluetooth HC05 Module
Blue TX
Blue RX
Blue_Key
BLUE_KEY
BLUE_RX
BLUE_TX
AUX ADC / DAC0
AUX ADC / DAC1
WI-FI TX
WI-FI RX
Only mounted on "End modules"
AISC-1206 -R10J-T
E. RS485 Power
MOSI SPI2
MISO SPI2
SCK_SPI2
750mA
Wifi TX
Wifi RX
WiFi GPIO0
WiFi GPIO2
WiFi VCC
WIFI-GPIO0
SIM5320E 3G GPRS module
3G Sleep
3G PowKey
3G TX
3G RX
3G_SLEEP
3G_RX
3G_TX
3G_POWKEY
Analog Vbat Measure
RS485-1 RX
RS485-1 TX
RS485-1 RE
RS485-1_DE
RS485-2 RX
CAN RX
CAN TX
RS485-2_RE
RS485-2_DE
TFT MOSI
TFT RESET
TFT CLK
TFT_CT-IRQ
TFT_CT-SCL
TFT_CT-SDA
TFT_BL_PWM
TFT MISO
TFT CS
i2c SCL3
i2c SDA3
+9-12v RS485
CS2_SPI2
CS1_SPI2
Vbat 12V
i2c_0
P OUT #1
P OUT #2
P OUT #3
P OUT #4
P OUT 04
P OUT 03
P OUT 02
P OUT 01
L1 OR R39 To be mounted
OK #01
OK #02
OK #03
VBAT_MEASURE
DS18B20_02
DS18B20 #01
P_OUT_06
P_OUT_05
P_OUT_07
P OUT #5
P OUT #6
P OUT #7
DS18B20 #03
DS18B20 #04
OK_01_IN
OK_02_IN
OK_03_IN
LDR IN
6A 70R@100mHZ
WI-FI_RESET
AUX2 D24
AUX2 D25
Vbat12V

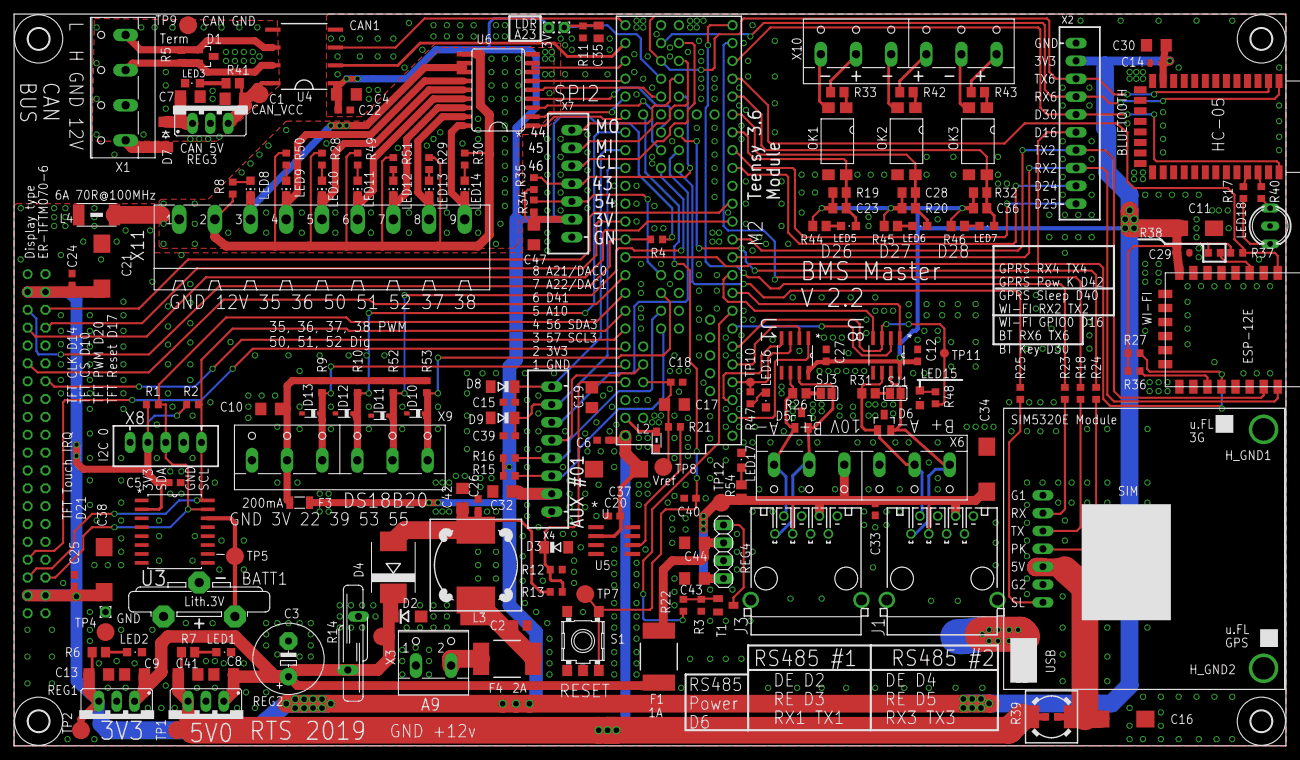
[picture p10: board BMS Master Teensy V 2.22 move 4G.brd from above]

Board: 2 copper layers, 181.0 x 104.1 mm, 189 parts (1 on the bottom side), 135 nets.

Other parts of the board:
U$2, U$4, U$6, U$7: 3,0
