Gigabyte1973/Gigabyte1973/(commit log)

2019-11-26 Add files via upload
    BMS V2.22, moved 4G modem
    [BMS Master Teensy V 2.22 move 4G.brd, BMS Master Teensy V 2.22 move 4G.sch]
2019-11-26 Add files via upload
    BMS Current sensor board. V1.11
    [Rs485 current sense V1.1.brd, Rs485 current sense V1.1.sch]
2019-11-26 Add files via upload
    BMS Battery SLAVE module V3.33
    [RS485 Slave BMS V3.3.brd, RS485 Slave BMS V3.3.sch]
2019-11-26 Add files via upload
    Current SLAVE V1.0
2019-11-26 Add files via upload
    BMS Jesper 4G V1.0
2019-12-02 BMS Master V2.3
    Store local charge time finished to EE-rom.
    Push Summer time from Blynk
    Make Outdoor TXT in display change color according to temp.
    Move hardcoded constants to ini file
    Routine to enable DC-DC when 12v get below threshold (ini file)
    Display (Fuel cap open) if Opto in D26 is High
    // Rasmus
