Gigabyte1973/Gigabyte1973/(notices)

Notices in the files:
parts and their libraries:
Wurth_Elektronik_Electromechanic_Power_E: Copyright: Würth Elektronik
